xxrrnn/EdgeYOLO-FPGA/docs/端到端执行网络测试方法说明.docx

四、测试方法

1. AI处理器芯片功能（支持ResNet、YOLO等主流深度神经网络）

（1）测试范围和端到端执行边界

使用项目顶层目录中的run.py作为AI处理器FPGA实物测试的统一入口。测试从原始JPEG图片开始，依次完成主机端图片预处理、模型程序和数据下发、FPGA主体网络执行、结果读回、Golden数值比对以及主机端网络头处理，最终生成YOLOv5n检测结果或ResNet18分类结果。

本测试所称“端到端”是由Windows主机与FPGA共同完成的异构执行流程。YOLOv5n在FPGA中执行model.0至model.23的backbone和FPN/PAN neck，model.24 Detect head、decode和NMS在主机CPU执行；ResNet18在FPGA中执行全部20个卷积、stem maxpool、downsample和residual add，Global Average Pool、FC和Top-k在主机CPU执行。Golden计算只用于验证FPGA输出，不属于被测网络的FPGA运算。

表1. 网络端到端执行边界

网络 | FPGA内执行 | Windows主机执行
YOLOv5n | model.0-model.23；57个卷积；im2col、DCIM矩阵乘、QA、DQA、maxpool、upsample和拼接 | 图片读取与letterbox；model.24 Detect head；decode、NMS、坐标映射、JSON和画框
ResNet18 | conv1、stem maxpool、4个stage、8个BasicBlock、20个卷积、downsample和residual add | 图片预处理；Global Average Pool、FC、logits排序、Top-k、JSON和结果图片
数值验证 | 不执行 | compare_one_shot.py生成Golden特征并与FPGA输出比较

（2）FPGA烧录和XDMA运行环境准备

FPGA板卡采用AMD/Xilinx VCU128，器件型号为xcvu37p-fsvh2892-2L-e。正式测试使用项目顶层目录bitstream文件夹下的edgeyolo_c1773f6_w8a8_w16a16w.bit。该bitstream对应250MHz主时钟和8个DCIM Tile，支持native INT8和widened INT16数据通路。

正式测试前，在连接VCU128 JTAG接口的计算机上打开Vivado Hardware Manager，连接目标器件并执行Program Device。run.py不会自动烧录bitstream。烧录计算机和Windows XDMA运行主机可以不是同一台，但板卡在烧录后必须保持供电，PCIe接口必须连接到运行run.py的Windows主机。烧录后重启Windows主机或重新枚举PCIe设备，在设备管理器中确认XDMA设备正常启动，再使用tests/bin/xdma_info.exe检查XDMA通道，并确认h2c_0和c2h_0能够访问。

Vivado/JTAG只负责配置FPGA逻辑；后续模型权重、输入数据、程序指令和控制寄存器均由Windows主机通过PCIe XDMA配置。因此报告中应分别记录“bitstream烧录”和“XDMA运行数据下发”，不能把二者合并描述为同一个步骤。

（3）输入图片和测试用例

正式测试输入取自项目顶层目录examples/coco和examples/imagenet。examples/coco/manifest.json记录20张COCO val2017图片，用于YOLOv5n目标检测；examples/imagenet/manifest.json记录20张ImageNet图片及其synset、类别编号和类别名称，用于ResNet18分类。每张图片分别执行INT8和widened INT16两种数据通路，因此YOLOv5n形成40个用例，ResNet18形成40个用例，共执行80个FPGA实测用例。

单次默认运行时，YOLOv5n输入为examples/coco/000000000139.jpg，ResNet18输入为examples/imagenet/n01443537_goldfish.JPEG。完整端到端测试在Windows XDMA主机的项目顶层目录执行以下命令：

python run.py --acceptance --network all --yolo-precision both --resnet-precision both --acceptance-examples 20 --vcs skip --verilator skip

该命令只执行FPGA端到端实测，不启动VCS峰值算力测试或本地Verilator预检。若只使用两张默认图片执行YOLOv5n INT8、YOLOv5n widened INT16、ResNet18 INT8和ResNet18 widened INT16四个用例，可直接执行：

python run.py

（4）量化模型的离线解析

模型解析和网络编译属于运行前的离线准备过程，不在每张图片推理时重新执行。正式实测直接使用已经固定的解析目录和artifacts/c1773f6编译产物。

YOLOv5n模型：

model/yolov5n_coco50k_qat/parse_quant_export.py中的parse_export函数读取best.quant.onnx和best.onnx，提取量化权重、权重scale、zero point和激活scale，从浮点模型读取BatchNorm参数，计算DQA scale和bias，将权重从OIHW转换为OHWI，并把各层参数写入weights文件夹下的NPZ文件。该程序还单独保存model.24 Detect head权重，供Windows主机端使用。正式测试使用parsed_int8和parsed_int16_widened两个解析目录。

ResNet18模型：

tests/chip/compiler/frontend/parse_resnet18_vai.py从Vitis AI PTQ模型ResNet_int.onnx中恢复20个卷积层的INT8权重和激活scale，生成DQA scale、bias、residual add输出scale以及FC权重和bias，输出到model/resnet18/parsed_vai。widened INT16目录为model/resnet18/parsed_vai_int16_widened。正式实测不要求重新运行Vitis AI或重新解析原始ONNX。

widened INT16保持INT8量化模型的权重数值和scale不变，只把量化值扩展到INT16数据通路中存储、传输和计算，用于验证FPGA 16bit数据通路；该模式不等同于独立训练和量化的原生W16A16网络。

（5）完整网络编译

神经网络编译入口为tests/chip/compiler/compile.py。正式测试的四组编译命令如下：

python tests/chip/compiler/compile.py --network yolov5n --mode int8 --full --parsed model/yolov5n_coco50k_qat/parsed_int8 --out artifacts/c1773f6/yolo_coco_int8
python tests/chip/compiler/compile.py --network yolov5n --mode int16 --full --parsed model/yolov5n_coco50k_qat/parsed_int16_widened --out artifacts/c1773f6/yolo_coco_int16_widened
python tests/chip/compiler/compile.py --network resnet18 --mode int8 --full --parsed model/resnet18/parsed_vai --out artifacts/c1773f6/resnet18_int8
python tests/chip/compiler/compile.py --network resnet18 --mode int16 --full --parsed model/resnet18/parsed_vai_int16_widened --out artifacts/c1773f6/resnet18_int16_widened

compile.py首先读取解析目录中的network.json和tests/chip/compiler/lowering/hw_caps.yaml，再调用lower_full.py中的lower_full函数，把卷积、maxpool、upsample、concat和residual add转换为处理器操作序列，并完成HBM、Tile IBUF/OBUF、VPU_BUF和WB地址规划。随后，weights_packer.py中的pack_all_layers生成weights.bin，wb_packer.py中的pack_all_layers生成wb.bin，insert_weight_load_ops在执行计划中插入逐层HBM到IBUF的权重搬运操作，encode_isa.py中的encode_plan将执行计划编码为32bit指令。

表2. 网络编译产物及作用

文件 | 作用
plan.json | 网络模式、地址表、输入输出位置、输出形状、数据类型和完整操作序列
program.bin / program.hex | 下发到FPGA指令存储器的二进制/十六进制程序
program_manifest.json | 程序分段信息；当前ResNet18 widened INT16使用两个程序段
weights.bin | 完整网络量化权重；每个one-shot用例开始时一次性上传到HBM
wb.bin | QA/DQA scale、bias等VPU参数
weights_layout.json | 各层权重在weights.bin中的偏移和大小
wb_layout.json | 各层scale、bias和VPU_BUF scratch偏移
memory_map.md | 编译器生成的可读存储地址说明

正式验收默认使用artifacts/c1773f6中已经固定的四组产物。run.py中的run_one_shot_fpga只有在指定编译目录缺少plan.json或显式要求重新编译时才调用_compile_one_shot_artifact。正式测试目录已经包含plan.json，因此测试过程中不重新生成模型参数。

（6）run.py的软件调用过程

run.py中的main函数解析网络、精度、输入图片和输出目录。使用--acceptance时，main调用run_acceptance_suite，按照数据集清单和精度组合建立80个用例。每个用例调用run_one_shot_fpga，并按以下顺序启动三个子程序：

1. tests/chip/runtime/hw_runner_win.py：完成图片预处理、XDMA下发、FPGA启动、状态轮询和结果读回。
2. tests/chip/runtime/compare_one_shot.py：生成软件Golden特征并与FPGA二进制输出逐元素比较。
3. tests/chip/runtime/one_shot_host_head.py：执行YOLO Detect head或ResNet GAP、FC和Top-k，生成最终JSON。

三个子程序均通过run.py中的_run_checked调用，并使用subprocess.run(check=True)执行。任何子程序以非零状态退出时，单次运行立即失败；在acceptance模式下，run_acceptance_suite捕获该异常，把对应图片和精度记录为FAIL，并继续执行后续用例。

（7）输入图片预处理和量化

YOLOv5n：

hw_runner_win.py中的make_yolo_input调用tests/chip/unit-tb/run.py中的load_image、letterbox和preprocess_yolov5n。load_image把JPEG读取为RGB uint8数组；letterbox保持长宽比缩放，并使用像素值114填充到320×320；preprocess_yolov5n把像素除以255，再按照解析目录network.json中的input_act_scale执行round和clip，生成INT8输入。widened INT16模式使用同一量化网格，并把量化结果保存为INT16。程序同时保留缩放比例和padding，用于最后把检测框坐标映射回原图。

ResNet18：

make_resnet_input调用tests/chip/unit-tb/resnet_e2e.py中的configure_resnet_precision、load_image和preprocess_resnet18。图片先缩放到256×256，再中心裁剪为224×224；像素除以255后使用ImageNet mean=[0.485,0.456,0.406]和std=[0.229,0.224,0.225]归一化，最后按照第一层输入激活scale量化为INT8或INT16。

硬件输入对齐：

im2col_unit按照每个像素16字节的步长读取第一层输入。hw_runner_win.py中的_pad_nhwc_input把三通道NHWC输入补零到每像素16字节。YOLOv5n实际上传320×320×16=1,638,400字节，ResNet18实际上传224×224×16=802,816字节。补零只改变内存布局，不改变三个有效通道的量化值。

（8）XDMA配置、数据和指令下发

Windows XDMA封装位于tests/chip/unit-tb/xdma_win.py。XDMAWin.write把待写数据保存为临时二进制文件，再调用tests/bin/xdma_rw.exe的h2c_0 write命令；XDMAWin.read调用c2h_0 read命令并读取临时输出文件。write_u32和read_u32在上述读写函数基础上完成32bit控制寄存器访问。

xdma_rw.exe h2c_0 write <address> -b -f <file> -l <length>
xdma_rw.exe c2h_0 read <address> -b -f <file> -l <length>

表3. FPGA运行时地址空间

区域 | 基地址 | 作用
HBM | 0x000000000 | 保存完整网络权重
Tile IBUF | 0x100000000 | 8个Tile的局部输入和权重缓冲区
Tile OBUF | 0x101000000 | 8个Tile的局部计算输出
VPU_BUF | 0x102000000 | 输入、中间特征、最终输出和WB scratch
WB | 0x103000000 | 当前层QA/DQA scale和bias
INST | 0x104000000 | 指令存储器
REGS | 0x105000000 | 解码器控制和状态寄存器

hw_runner_win.py中的main函数首先读取编译目录中的plan.json，从address_map和host_io取得存储基地址、输入偏移、输出偏移、输出形状和数据类型，然后按以下顺序执行：

1. 默认调用soft_reset_decoder，将INST_COUNT写0，并向DECODER_CTRL写1和0，对指令译码器执行局部软复位。

2. 读取DECODER_STATUS；若bit0为1，表示解码器仍处于busy状态，本次运行停止。

3. 把weights.bin一次性写入HBM基地址加0x200000偏移。

4. 把wb.bin写入wb_layout.json指定的VPU_BUF scratch区域。

5. 把预处理并补齐后的输入写入host_io.input_obuf_off；当前四组正式程序均从VPU_BUF偏移0存放输入。

6. 调用load_programs读取program.bin；若存在program_manifest.json，则按manifest顺序读取多个程序段。

7. 把当前程序段写入0x104000000的INST存储器。

write_chunked默认按1MB分块写入大文件。每次重要写入完成后，verify_write_tail读回写入区域末尾最多16字节，使PCIe/XDMA写缓冲完成提交。主机不逐层上传权重；完整weights.bin只上传一次，FPGA运行期间由程序中的CDMA操作把当前层权重从HBM搬运到对应Tile IBUF。

（9）FPGA程序启动和主体网络执行

程序和数据准备完成后，hw_runner_win.py中的start_and_poll将当前程序段的32bit指令字数写入REGS+0x3C的INST_COUNT寄存器，再向REGS+0x38的DECODER_CTRL依次写1和0，产生程序启动脉冲。程序运行期间每2ms读取REGS+0x40的DECODER_STATUS：bit1为1表示本程序段完成，bit31为1表示解码器报告错误；超过--one-shot-poll-timeout-s仍未完成则判定timeout。

指令译码器按照plan.json中的操作顺序调度CDMA、VPU和DCIM。cdma_copy/cdma_stride完成HBM、Tile IBUF/OBUF、VPU_BUF和WB之间的数据搬运；VPU im2col把卷积输入特征转换为矩阵乘输入；dcim_layer控制8个DCIM Tile完成INT8或widened INT16矩阵计算；DQA对整数累加结果乘scale、加bias并执行激活；QA把FP32特征重新量化为下一卷积层所需的整数数据；mp、us和ad分别执行maxpool、upsample和residual add；concat通过编译器规划的通道偏移和CDMA搬运完成。

网络中间特征始终保存在FPGA缓冲区中，程序执行期间不返回主机。ResNet18 widened INT16程序虽然分为两个指令段，但第一段结束后中间特征仍保留在VPU_BUF中，Windows主机只替换INST中的下一段指令，不执行中间网络计算。

（10）FPGA输出读回

全部程序段执行完成后，hw_runner_win.py中的output_specs读取plan.json中的host_io。read_chunked通过XDMA C2H通道按--one-shot-read-chunk-bytes指定的大小分块读回输出。

表4. FPGA输出特征

网络与精度 | FPGA输出 | 数据类型
YOLOv5n INT8 / widened INT16 | PAN_P3 40×40×64；PAN_P4 20×20×128；PAN_P5 10×10×256 | FP32
ResNet18 INT8 | GAP之前的7×7×512特征 | INT8
ResNet18 widened INT16 | GAP之前的7×7×512特征 | INT16

YOLOv5n三组特征分别保存为features/PAN_P3.bin、features/PAN_P4.bin和features/PAN_P5.bin。ResNet18把7×7×512特征保存为当前用例的主输出bin文件。每次运行同时生成同名的_timing.json，记录权重、WB、输入和程序上传时间，各程序段执行和状态轮询时间，输出读回时间及整个用例的主机侧总时间。该时间是Windows主机测得的墙钟时间，不等同于VCS峰值算力测试中的纯硬件有效计算窗口。

（11）FPGA输出和Golden结果比对

FPGA结果读回后，run.py调用tests/chip/runtime/compare_one_shot.py。YOLOv5n使用run_yolo_compiler_golden读取network.json和各层NPZ参数，按照YOLOV5N_SCHEDULE依次执行conv、save、load、concat、upsample、maxpool和add，卷积部分采用与FPGA相同的im2col、整数矩阵乘、DQA scale、bias和量化规则，生成PAN_P3、PAN_P4和PAN_P5参考特征。

ResNet18使用run_resnet_compiler_golden依次执行conv1、3×3 stride-2 maxpool、8个BasicBlock、downsample和residual add，生成与FPGA输出位置一致的7×7×512参考特征。

compare_one_shot.py按照plan.json中的输出形状和数据类型读取FPGA二进制结果，把FPGA输出和Golden输出转换为FP32后逐元素相减，并计算最大绝对误差max_abs、平均绝对误差mean_abs和均方根误差rmse。默认atol为1e-3；任一应比对输出的max_abs大于1e-3时，程序以非零状态退出，该用例判定为FAIL。Golden计算、误差统计和PASS/FAIL判断均在Windows CPU上执行，不属于FPGA网络运算。正式测试需要保存终端日志，用于记录每组输出的误差统计。

（12）主机端网络头和最终结果

YOLOv5n：

one_shot_host_head.py中的_run_yolo读取PAN_P3、PAN_P4和PAN_P5，根据三个尺度的激活scale把FPGA输出的FP32特征重新量化到INT8或INT16网格，再调用tests/chip/unit-tb/detect_head.py中的DetectHead.forward执行model.24的三个1×1卷积。DetectHead.postprocess完成sigmoid、anchor/grid decode、置信度过滤和分类别NMS。程序最后依据letterbox比例和padding把检测框映射回原图，生成包含bbox、conf、class_score、class_id和class_name的JSON。run.py中的_draw_yolo_detections把检测框、类别和置信度绘制到原始图片。

ResNet18：

one_shot_host_head.py中的_run_resnet读取7×7×512 INT8或INT16特征，对两个空间维度求均值完成Global Average Pool，再乘以最后一个BasicBlock的输出激活scale。程序从对应解析目录weights/fc.npz读取FC weight和bias，计算logits=gap×weight+bias，对logits从大到小排序得到Top-5类别，并从model/resnet18/imagenet_labels.json读取类别名称。run.py中的_draw_resnet_classification生成带Top-5文字面板的结果图片。当前代码未执行softmax，因此JSON中的score为原始logit，不应写成分类概率。

（13）输出文件位置和内容

使用两张默认图片执行python run.py时，输出位于output/inference。使用完整acceptance命令时，输出位于output/acceptance。主要目录如下：

output/inference/yolo_coco/one_shot_int8
output/inference/yolo_coco/one_shot_int16
output/inference/resnet/one_shot_int8
output/inference/resnet/one_shot_int16
output/acceptance/yolo_coco/one_shot_int8
output/acceptance/yolo_coco/one_shot_int16
output/acceptance/resnet/one_shot_int8
output/acceptance/resnet/one_shot_int16

表5. 单个用例主要输出文件

文件 | 内容
*_fpga_oneshot.bin | FPGA主输出二进制特征
features/PAN_P3.bin等 | YOLOv5n三尺度FP32 PAN特征
*_fpga_oneshot.json | 最终检测结果或ResNet18 Top-k结果
*_fpga_oneshot.jpg | 带检测框或Top-k文字面板的结果图片
*_fpga_oneshot_timing.json | 权重、WB、输入、程序、执行和读回阶段时间

全部用例结束后，run_acceptance_suite在output/acceptance中生成acceptance_report.json和acceptance_report.md，记录每张图片的网络、精度、PASS/FAIL、检测数量或Top-1类别及运行时间。

（14）测试判定口径

当前run_acceptance_suite把“FPGA特征通过Golden比对，且主机端网络头能够正常完成”作为单个用例的PASS条件。ResNet18的top1_matches_sample_label会写入汇总报告，但当前不作为用例FAIL门槛；YOLOv5n记录检测数量，但不计算COCO mAP。因此，本测试可以证明FPGA主体网络计算正确、YOLOv5n和ResNet18端到端流程可运行，以及INT8和widened INT16数据通路能够完成实测；不能把该结果直接表述为完整ImageNet分类精度或COCO mAP测试。

正式报告应至少保留：Vivado烧录截图、Windows设备管理器XDMA状态、完整测试命令和终端日志、四组网络与精度的PASS/FAIL汇总、代表性YOLO检测图片、代表性ResNet18 Top-5图片、FPGA与Golden误差统计，以及各用例的timing.json。

（15）软件文件和函数调用汇总

表6. 端到端软件调用链

阶段 | 文件与函数 | 作用
测试入口 | run.py::main | 解析网络、精度、输入和运行模式
用例组织 | run.py::run_acceptance_suite | 按manifest、网络和精度建立80个测试用例
单次执行 | run.py::run_one_shot_fpga | 选择编译产物并依次启动硬件、比对和主机网络头
YOLO输入 | hw_runner_win.py::make_yolo_input | letterbox、归一化和INT8/INT16量化
ResNet输入 | hw_runner_win.py::make_resnet_input | resize、center crop、ImageNet归一化和量化
输入对齐 | hw_runner_win.py::_pad_nhwc_input | 把三通道输入补零到每像素16字节
XDMA写入 | xdma_win.py::XDMAWin.write/write_u32 | 通过h2c_0写数据、指令和控制寄存器
XDMA读回 | xdma_win.py::XDMAWin.read/read_u32 | 通过c2h_0读取状态和FPGA输出
程序加载 | hw_runner_win.py::load_programs | 读取单段program.bin或program_manifest中的多段程序
启动轮询 | hw_runner_win.py::start_and_poll | 配置INST_COUNT、产生启动脉冲并轮询DECODER_STATUS
结果读回 | hw_runner_win.py::output_specs/read_chunked | 按plan.json读取指定输出特征
YOLO Golden | compare_one_shot.py::run_yolo_compiler_golden | 生成三尺度PAN参考特征
ResNet Golden | compare_one_shot.py::run_resnet_compiler_golden | 生成7×7×512参考特征
数值判定 | compare_one_shot.py::main | 计算max_abs、mean_abs、rmse并按atol判定
YOLO主机头 | one_shot_host_head.py::_run_yolo | Detect head、decode、NMS和检测JSON
ResNet主机头 | one_shot_host_head.py::_run_resnet | GAP、FC、logits排序和Top-k JSON
结果图片 | run.py::_draw_yolo_detections/_draw_resnet_classification | 绘制检测框或分类Top-k面板
