xxrrnn/EdgeYOLO-FPGA/rtl/vpu/CDMA_Controller.sv

`timescale 1ns / 1ns

`include "chip_defines.vh"
`ifndef CDMA_COOLDOWN_CYCLES
`define CDMA_COOLDOWN_CYCLES 2000
`endif

	module CDMA_Controller # (
        parameter int CDMA_BASE_ADDR = 0,
        parameter int C_CDMA_AXILM_ADDR_WIDTH = 32,
        parameter int C_CDMA_AXILM_DATA_WIDTH = 32
    ) (
        input wire        clk,
        input wire        rst_n,
        input wire        cdma_start,
        input wire        cdma_config_valid,
        output wire       cdma_config_ready,
        input wire [31:0] cdma_src_addr_msb,
        input wire [31:0] cdma_src_addr_lsb,
        input wire [31:0] cdma_dst_addr_msb, 
        input wire [31:0] cdma_dst_addr_lsb,
        input wire [31:0] cdma_length,

        output logic [C_CDMA_AXILM_ADDR_WIDTH-1 : 0] cdma_axilm_awaddr,
        output logic [2 : 0] cdma_axilm_awprot,
        output logic cdma_axilm_awvalid,
        input  logic cdma_axilm_awready,
        output logic [C_CDMA_AXILM_DATA_WIDTH-1 : 0] cdma_axilm_wdata,
        output logic [C_CDMA_AXILM_DATA_WIDTH/8-1 : 0] cdma_axilm_wstrb,
        output logic cdma_axilm_wvalid,
        input  logic cdma_axilm_wready,
        input  logic [1 : 0] cdma_axilm_bresp,
        input  logic cdma_axilm_bvalid,
        output logic cdma_axilm_bready,
        output logic [C_CDMA_AXILM_ADDR_WIDTH-1 : 0] cdma_axilm_araddr,
        output logic [2 : 0] cdma_axilm_arprot,
        output logic cdma_axilm_arvalid,
        input  logic cdma_axilm_arready,
        input  logic [C_CDMA_AXILM_DATA_WIDTH-1 : 0] cdma_axilm_rdata,
        input  logic [1 : 0] cdma_axilm_rresp,
        input  logic cdma_axilm_rvalid,
        output logic cdma_axilm_rready
    );

    wire aw_handshake_cdma = cdma_axilm_awready && cdma_axilm_awvalid;
    wire w_handshake_cdma  = cdma_axilm_wready  && cdma_axilm_wvalid;
    wire b_handshake_cdma  = cdma_axilm_bvalid  && cdma_axilm_bready;
    wire ar_handshake_cdma = cdma_axilm_arready && cdma_axilm_arvalid;
    wire r_handshake_cdma  = cdma_axilm_rvalid  && cdma_axilm_rready;

    reg [31:0] cdma_src_addr_msb_reg;
    reg [31:0] cdma_src_addr_lsb_reg;
    reg [31:0] cdma_dst_addr_msb_reg;
    reg [31:0] cdma_dst_addr_lsb_reg;
    reg [31:0] cdma_length_reg;
    reg        sr_idle_flag;  // 锁存 SR 读取结果的 IDLE 位
    reg [$clog2(`CDMA_COOLDOWN_CYCLES+1)-1:0] cooldown_cnt;
    reg        write_addr_done;
    reg        write_data_done;
    reg        write_resp_done;

    assign cdma_axilm_awprot = '0;
    assign cdma_axilm_arprot = '0;

    typedef enum logic [7:0] {
        IDLE                = 8'd0,
        CDMA_CONFIG         = 8'd1,   // 发起 SR 读请求
        CDMA_CHECK          = 8'd2,   // 等待 SR 响应，确认 CDMA IDLE
        CDMA_ENABLE_IRQ     = 8'd3,
        CDMA_ENABLE_IRQ_CLR = 8'd4,
        CDMA_WRITE_SRC_MSB  = 8'd5,
        CDMA_WRITE_SRC_MSB_CLR = 8'd6,
        CDMA_WRITE_SRC_LSB  = 8'd7,
        CDMA_WRITE_SRC_LSB_CLR = 8'd8,
        CDMA_WRITE_DST_MSB  = 8'd9,
        CDMA_WRITE_DST_MSB_CLR = 8'd10,
        CDMA_WRITE_DST_LSB  = 8'd11,
        CDMA_WRITE_DST_LSB_CLR = 8'd12,
        CDMA_WRITE_LEN      = 8'd13,
        CDMA_WRITE_LEN_CLR  = 8'd14,
        CDMA_POLL_ISSUE     = 8'd15,  // 发起 SR 读请求（轮询传输完成）
        CDMA_POLL_WAIT      = 8'd16,  // 等待 SR 响应
        CDMA_POLL_CHECK     = 8'd17,  // 检查 IDLE 位，决定结束或重试
        CDMA_COOLDOWN       = 8'd18   // 等待 AXI 写路径完全 flush
    } state_t;
    (* fsm_encoding = "one_hot" *) state_t n_state, c_state;

    assign cdma_config_ready = c_state == IDLE;

    wire cdma_write_state =
        (c_state == CDMA_ENABLE_IRQ) ||
        (c_state == CDMA_WRITE_SRC_MSB) ||
        (c_state == CDMA_WRITE_SRC_LSB) ||
        (c_state == CDMA_WRITE_DST_MSB) ||
        (c_state == CDMA_WRITE_DST_LSB) ||
        (c_state == CDMA_WRITE_LEN);
    wire cdma_write_done =
        (write_addr_done || aw_handshake_cdma) &&
        (write_data_done || w_handshake_cdma) &&
        (write_resp_done || b_handshake_cdma);

    always_ff @(posedge clk or negedge rst_n) begin
        if (!rst_n)
            c_state <= IDLE;
        else
            c_state <= n_state;
    end

    always_comb begin
        n_state = c_state;
        case (c_state)
            IDLE:             if (cdma_start) n_state = CDMA_CONFIG;
            CDMA_CONFIG:      n_state = CDMA_CHECK;
            CDMA_CHECK:       if (r_handshake_cdma && cdma_axilm_rdata[1]) n_state = CDMA_ENABLE_IRQ;

            CDMA_ENABLE_IRQ:        if (cdma_write_done) n_state = CDMA_ENABLE_IRQ_CLR;
            CDMA_ENABLE_IRQ_CLR:    n_state = CDMA_WRITE_SRC_MSB;
            CDMA_WRITE_SRC_MSB:     if (cdma_write_done) n_state = CDMA_WRITE_SRC_MSB_CLR;
            CDMA_WRITE_SRC_MSB_CLR: n_state = CDMA_WRITE_SRC_LSB;
            CDMA_WRITE_SRC_LSB:     if (cdma_write_done) n_state = CDMA_WRITE_SRC_LSB_CLR;
            CDMA_WRITE_SRC_LSB_CLR: n_state = CDMA_WRITE_DST_MSB;
            CDMA_WRITE_DST_MSB:     if (cdma_write_done) n_state = CDMA_WRITE_DST_MSB_CLR;
            CDMA_WRITE_DST_MSB_CLR: n_state = CDMA_WRITE_DST_LSB;
            CDMA_WRITE_DST_LSB:     if (cdma_write_done) n_state = CDMA_WRITE_DST_LSB_CLR;
            CDMA_WRITE_DST_LSB_CLR: n_state = CDMA_WRITE_LEN;
            CDMA_WRITE_LEN:         if (cdma_write_done) n_state = CDMA_WRITE_LEN_CLR;
            CDMA_WRITE_LEN_CLR:     n_state = CDMA_POLL_ISSUE;

            // 轮询 CDMA SR 直到 IDLE=1（传输完成）
            CDMA_POLL_ISSUE:  n_state = CDMA_POLL_WAIT;
            CDMA_POLL_WAIT:   if (r_handshake_cdma) n_state = CDMA_POLL_CHECK;
            CDMA_POLL_CHECK:  if (sr_idle_flag) n_state = CDMA_COOLDOWN;
                              else              n_state = CDMA_POLL_ISSUE;

            // 等待 AXI 互连写路径完全 flush 到目标 BRAM
            CDMA_COOLDOWN:    if (cooldown_cnt == `CDMA_COOLDOWN_CYCLES) n_state = IDLE;

            default: n_state = IDLE;
        endcase
    end

    // Register offsets within CDMA peripheral
    localparam logic [31:0] CDMA_CR_OFFSET             = 32'h00000000;
    localparam logic [31:0] CDMA_SR_OFFSET             = 32'h00000004;
    localparam logic [31:0] CDMA_SRC_ADDR_LSB_OFFSET   = 32'h00000018;
    localparam logic [31:0] CDMA_SRC_ADDR_MSB_OFFSET   = 32'h0000001C;
    localparam logic [31:0] CDMA_DST_ADDR_LSB_OFFSET   = 32'h00000020;
    localparam logic [31:0] CDMA_DST_ADDR_MSB_OFFSET   = 32'h00000024;
    localparam logic [31:0] CDMA_LEN_OFFSET            = 32'h00000028;
    localparam int          RUN_STOP_BIT               = 0;
    localparam int          IOC_IRQ_EN_BIT             = 12;
    localparam int          ERR_IRQ_EN_BIT             = 14;

    // 锁存 SR 读取结果
    always_ff @(posedge clk or negedge rst_n) begin
        if (!rst_n)
            sr_idle_flag <= 1'b0;
        else if (r_handshake_cdma)
            sr_idle_flag <= cdma_axilm_rdata[1];
    end

    // Cooldown 计数器：CDMA 完成后等待写路径 flush
    always_ff @(posedge clk or negedge rst_n) begin
        if (!rst_n)
            cooldown_cnt <= '0;
        else if (c_state == CDMA_COOLDOWN)
            cooldown_cnt <= cooldown_cnt + 1;
        else
            cooldown_cnt <= '0;
    end

    always_ff @(posedge clk or negedge rst_n) begin
        if (!rst_n) begin
            write_addr_done <= 1'b0;
            write_data_done <= 1'b0;
            write_resp_done <= 1'b0;
        end else if (!cdma_write_state) begin
            write_addr_done <= 1'b0;
            write_data_done <= 1'b0;
            write_resp_done <= 1'b0;
        end else begin
            if (aw_handshake_cdma) write_addr_done <= 1'b1;
            if (w_handshake_cdma)  write_data_done <= 1'b1;
            if (b_handshake_cdma)  write_resp_done <= 1'b1;
        end
    end

    // AXI-Lite 输出信号
    always_ff @(posedge clk or negedge rst_n) begin
        if (!rst_n) begin
            cdma_axilm_awvalid <= 1'b0;
            cdma_axilm_wvalid  <= 1'b0;
            cdma_axilm_bready  <= 1'b0;
            cdma_axilm_arvalid <= 1'b0;
            cdma_axilm_rready  <= 1'b0;
            cdma_axilm_awaddr  <= '0;
            cdma_axilm_wdata   <= '0;
            cdma_axilm_wstrb   <= '0;
        end else begin
            case (c_state)
                CDMA_CONFIG: begin
                    cdma_axilm_arvalid <= 1;
                    cdma_axilm_araddr  <= CDMA_BASE_ADDR + CDMA_SR_OFFSET;
                    cdma_axilm_rready  <= 1;
                end
                CDMA_CHECK: begin
                    cdma_axilm_arvalid <= ~ar_handshake_cdma;
                    cdma_axilm_araddr  <= CDMA_BASE_ADDR + CDMA_SR_OFFSET;
                    cdma_axilm_rready  <= 1;
                end
                CDMA_ENABLE_IRQ: begin
                    cdma_axilm_awvalid <= ~write_addr_done;
                    cdma_axilm_awaddr  <= CDMA_BASE_ADDR + CDMA_CR_OFFSET;
                    cdma_axilm_wvalid  <= ~write_data_done;
                    // AXI CDMA requires CR.RS=1 before SRC/DST/LEN writes can start a transfer.
                    cdma_axilm_wdata   <= (1 << RUN_STOP_BIT) | (1 << IOC_IRQ_EN_BIT) | (1 << ERR_IRQ_EN_BIT);
                    cdma_axilm_wstrb   <= {C_CDMA_AXILM_DATA_WIDTH/8{1'b1}};
                    cdma_axilm_bready  <= 1;
                end
                CDMA_WRITE_SRC_MSB: begin
                    cdma_axilm_awvalid <= ~write_addr_done;
                    cdma_axilm_awaddr  <= CDMA_BASE_ADDR + CDMA_SRC_ADDR_MSB_OFFSET;
                    cdma_axilm_wvalid  <= ~write_data_done;
                    cdma_axilm_wdata   <= cdma_src_addr_msb_reg;
                    cdma_axilm_wstrb   <= {C_CDMA_AXILM_DATA_WIDTH/8{1'b1}};
                    cdma_axilm_bready  <= 1;
                end
                CDMA_WRITE_SRC_LSB: begin
                    cdma_axilm_awvalid <= ~write_addr_done;
                    cdma_axilm_awaddr  <= CDMA_BASE_ADDR + CDMA_SRC_ADDR_LSB_OFFSET;
                    cdma_axilm_wvalid  <= ~write_data_done;
                    cdma_axilm_wdata   <= cdma_src_addr_lsb_reg;
                    cdma_axilm_wstrb   <= {C_CDMA_AXILM_DATA_WIDTH/8{1'b1}};
                    cdma_axilm_bready  <= 1;
                end
                CDMA_WRITE_DST_MSB: begin
                    cdma_axilm_awvalid <= ~write_addr_done;
                    cdma_axilm_awaddr  <= CDMA_BASE_ADDR + CDMA_DST_ADDR_MSB_OFFSET;
                    cdma_axilm_wvalid  <= ~write_data_done;
                    cdma_axilm_wdata   <= cdma_dst_addr_msb_reg;
                    cdma_axilm_wstrb   <= {C_CDMA_AXILM_DATA_WIDTH/8{1'b1}};
                    cdma_axilm_bready  <= 1;
                end
                CDMA_WRITE_DST_LSB: begin
                    cdma_axilm_awvalid <= ~write_addr_done;
                    cdma_axilm_awaddr  <= CDMA_BASE_ADDR + CDMA_DST_ADDR_LSB_OFFSET;
                    cdma_axilm_wvalid  <= ~write_data_done;
                    cdma_axilm_wdata   <= cdma_dst_addr_lsb_reg;
                    cdma_axilm_wstrb   <= {C_CDMA_AXILM_DATA_WIDTH/8{1'b1}};
                    cdma_axilm_bready  <= 1;
                end
                CDMA_WRITE_LEN: begin
                    cdma_axilm_awvalid <= ~write_addr_done;
                    cdma_axilm_awaddr  <= CDMA_BASE_ADDR + CDMA_LEN_OFFSET;
                    cdma_axilm_wvalid  <= ~write_data_done;
                    cdma_axilm_wdata   <= cdma_length_reg;
                    cdma_axilm_wstrb   <= {C_CDMA_AXILM_DATA_WIDTH/8{1'b1}};
                    cdma_axilm_bready  <= 1;
                end
                CDMA_POLL_ISSUE: begin
                    // 发起读 SR 请求
                    cdma_axilm_arvalid <= 1;
                    cdma_axilm_araddr  <= CDMA_BASE_ADDR + CDMA_SR_OFFSET;
                    cdma_axilm_rready  <= 1;
                end
                CDMA_POLL_WAIT: begin
                    // 等待读响应，ar握手后清 arvalid
                    cdma_axilm_arvalid <= ~ar_handshake_cdma;
                    cdma_axilm_araddr  <= CDMA_BASE_ADDR + CDMA_SR_OFFSET;
                    cdma_axilm_rready  <= 1;
                end
                CDMA_POLL_CHECK: begin
                    // 清零所有信号，检查结果
                    cdma_axilm_awvalid <= 1'b0;
                    cdma_axilm_wvalid  <= 1'b0;
                    cdma_axilm_bready  <= 1'b0;
                    cdma_axilm_arvalid <= 1'b0;
                    cdma_axilm_rready  <= 1'b0;
                end
                // _CLR 状态：清零所有 valid 信号
                CDMA_ENABLE_IRQ_CLR,
                CDMA_WRITE_SRC_MSB_CLR,
                CDMA_WRITE_SRC_LSB_CLR,
                CDMA_WRITE_DST_MSB_CLR,
                CDMA_WRITE_DST_LSB_CLR,
                CDMA_WRITE_LEN_CLR: begin
                    cdma_axilm_awvalid <= 1'b0;
                    cdma_axilm_wvalid  <= 1'b0;
                    cdma_axilm_bready  <= 1'b0;
                    cdma_axilm_arvalid <= 1'b0;
                    cdma_axilm_rready  <= 1'b0;
                end
                IDLE: begin
                    cdma_axilm_awvalid <= 1'b0;
                    cdma_axilm_wvalid  <= 1'b0;
                    cdma_axilm_bready  <= 1'b0;
                    cdma_axilm_arvalid <= 1'b0;
                    cdma_axilm_rready  <= 1'b0;
                end
                default: begin
                    cdma_axilm_awvalid <= 1'b0;
                    cdma_axilm_wvalid  <= 1'b0;
                    cdma_axilm_bready  <= 1'b0;
                    cdma_axilm_arvalid <= 1'b0;
                    cdma_axilm_rready  <= 1'b0;
                end
            endcase
        end
    end

    // 锁存配置参数
    always_ff @(posedge clk or negedge rst_n) begin
        if(!rst_n) begin
            cdma_src_addr_msb_reg       <= '0;
            cdma_src_addr_lsb_reg       <= '0;
            cdma_dst_addr_msb_reg       <= '0;
            cdma_dst_addr_lsb_reg       <= '0;
            cdma_length_reg             <= '0;
        end else begin
            if(cdma_config_valid && cdma_config_ready) begin
                cdma_src_addr_msb_reg       <= cdma_src_addr_msb;
                cdma_src_addr_lsb_reg       <= cdma_src_addr_lsb;
                cdma_dst_addr_msb_reg       <= cdma_dst_addr_msb;
                cdma_dst_addr_lsb_reg       <= cdma_dst_addr_lsb;
                cdma_length_reg             <= cdma_length;
            end
        end
    end

endmodule
