xxrrnn/EdgeYOLO-FPGA/xdc/chip/chip.xdc

# DCIM_Array Chip XDC constraints
# Based on VCU128 board (xcvu37p-fsvh2892-2L-e)

# PCIe reference clock
set_property PACKAGE_PIN AR14 [get_ports pcie_refclk_clk_n]
set_property PACKAGE_PIN AR15 [get_ports pcie_refclk_clk_p]

# CPU reset button
set_property PACKAGE_PIN BM29 [get_ports cpu_reset]
set_property IOSTANDARD LVCMOS12 [get_ports cpu_reset]

# User link up LED
set_property PACKAGE_PIN BH24 [get_ports user_lnk_up_0]
set_property IOSTANDARD LVCMOS18 [get_ports user_lnk_up_0]

# Bitstream configuration
set_property CONFIG_MODE SPIx4 [current_design]
set_property BITSTREAM.CONFIG.CONFIGRATE 63.8 [current_design]
