xxrrnn/EdgeYOLO-FPGA/rtl/ref/DCIM/src/sram/rf128x128/verilog/rf128x128.v

/* verilog_memcomp Version: c0.4.19-EAC */
/* common_memcomp Version: c0.4.19-EAC */
/* lang compiler Version: 4.14.4-EAC Mar 31 2020 06:59:59 */
//
//       CONFIDENTIAL AND PROPRIETARY SOFTWARE OF ARM PHYSICAL IP, INC.
//      
//       Copyright (c) 1993 - 2026 ARM Physical IP, Inc.  All Rights Reserved.
//      
//       Use of this Software is subject to the terms and conditions of the
//       applicable license agreement with ARM Physical IP, Inc.
//       In addition, this Software is protected by patents, copyright law 
//       and international treaties.
//      
//       The copyright notice(s) in this Software does not indicate actual or
//       intended publication of this Software.
//
//      Verilog model for High Density Single Port Register File SVT MVT Compiler
//
//       Instance Name:              rf128x128
//       Words:                      128
//       Bits:                       128
//       Mux:                        2
//       Drive:                      6
//       Write Mask:                 On
//       Write Thru:                 Off
//       Extra Margin Adjustment:    On
//       Test Muxes                  Off
//       Power Gating:               Off
//       Retention:                  On
//       Pipeline:                   Off
//       Read Disturb Test:	        Off
//       
//       Creation Date:  Fri Apr  3 17:16:28 2026
//       Version: 	r0p0
//
//      Modeling Assumptions: This model supports full gate level simulation
//          including proper x-handling and timing check behavior.  Unit
//          delay timing is included in the model. Back-annotation of SDF
//          (v3.0 or v2.1) is supported.  SDF can be created utilyzing the delay
//          calculation views provided with this generator and supported
//          delay calculators.  All buses are modeled [MSB:LSB].  All 
//          ports are padded with Verilog primitives.
//
//      Modeling Limitations: None.
//
//      Known Bugs: None.
//
//      Known Work Arounds: N/A
//
`timescale 1 ns/1 ps
`define ARM_MEM_PROP 1.000
`define ARM_MEM_RETAIN 1.000
`define ARM_MEM_PERIOD 3.000
`define ARM_MEM_WIDTH 1.000
`define ARM_MEM_SETUP 1.000
`define ARM_MEM_HOLD 0.500
`define ARM_MEM_COLLISION 3.000
// If ARM_UD_MODEL is defined at Simulator Command Line, it Selects the Fast Functional Model
`ifdef ARM_UD_MODEL

// Following parameter Values can be overridden at Simulator Command Line.

// ARM_UD_DP Defines the delay through Data Paths, for Memory Models it represents BIST MUX output delays.
`ifdef ARM_UD_DP
`else
`define ARM_UD_DP #0.001
`endif
// ARM_UD_CP Defines the delay through Clock Path Cells, for Memory Models it is not used.
`ifdef ARM_UD_CP
`else
`define ARM_UD_CP
`endif
// ARM_UD_SEQ Defines the delay through the Memory, for Memory Models it is used for CLK->Q delays.
`ifdef ARM_UD_SEQ
`else
`define ARM_UD_SEQ #0.01
`endif

`celldefine
// If POWER_PINS is defined at Simulator Command Line, it selects the module definition with Power Ports
`ifdef POWER_PINS
module rf128x128 (VDDCE, VDDPE, VSSE, q, clk, cen, wen, a, d, ema, emaw, emas, gwen,
    ret1n);
`else
module rf128x128 (q, clk, cen, wen, a, d, ema, emaw, emas, gwen, ret1n);
`endif

  parameter ASSERT_PREFIX = "";
  parameter BITS = 128;
  parameter WORDS = 128;
  parameter MUX = 2;
  parameter MEM_WIDTH = 256; // redun block size 2, 128 on left, 128 on right
  parameter MEM_HEIGHT = 64;
  parameter WP_SIZE = 1 ;
  parameter UPM_WIDTH = 3;
  parameter UPMW_WIDTH = 2;
  parameter UPMS_WIDTH = 1;

`ifdef ARM_DISABLE_EMA_CHECK
parameter ARM_LOCAL_DISABLE_EMA_CHECK = 1;
`else
parameter ARM_LOCAL_DISABLE_EMA_CHECK = 0;
`endif

  parameter ARM_REF_EMA_VALUE = 2**UPM_WIDTH-1;
  parameter ARM_REF_EMAW_VALUE = 2**UPMW_WIDTH-1;
  parameter ARM_REF_EMAS_VALUE = 2**UPMS_WIDTH-1;

  output [127:0] q;
  input  clk;
  input  cen;
  input [127:0] wen;
  input [6:0] a;
  input [127:0] d;
  input [2:0] ema;
  input [1:0] emaw;
  input  emas;
  input  gwen;
  input  ret1n;
`ifdef POWER_PINS
  inout VDDCE;
  inout VDDPE;
  inout VSSE;
`endif
`ifdef POWER_PINS
  reg bad_VDDCE;
  reg bad_VDDPE;
  reg bad_VSSE;
  reg bad_power;
`endif
 wire corrupt_power;
`ifdef POWER_PINS
  assign corrupt_power = bad_power;
`else
  assign corrupt_power = 1'b0;
`endif

  reg pre_charge_st;
  integer row_address;
  integer mux_address;
  initial row_address = 0;
  initial mux_address = 0;
  reg [255:0] mem [0:63];
  reg [255:0] row, row_t;
  reg LAST_clk;
  reg [255:0] row_mask;
  reg [255:0] new_data;
  reg [255:0] data_out;
  reg [127:0] readLatch0;
  reg [127:0] shifted_readLatch0;
  reg [127:0] q_int;
  reg [127:0] writeEnable;
  reg clk0_int;

  wire [127:0] q_;
 wire  clk_;
  wire  cen_;
  reg  cen_int;
  reg  cen_p2;
  wire [127:0] wen_;
  reg [127:0] wen_int;
  wire [6:0] a_;
  reg [6:0] a_int;
  wire [127:0] d_;
  reg [127:0] d_int;
  wire [2:0] ema_;
  reg [2:0] ema_int;
  wire [1:0] emaw_;
  reg [1:0] emaw_int;
  wire  emas_;
  reg  emas_int;
  wire  gwen_;
  reg  gwen_int;
  wire  ret1n_;
  reg  ret1n_int;

  assign q[0] = q_[0]; 
  assign q[1] = q_[1]; 
  assign q[2] = q_[2]; 
  assign q[3] = q_[3]; 
  assign q[4] = q_[4]; 
  assign q[5] = q_[5]; 
  assign q[6] = q_[6]; 
  assign q[7] = q_[7]; 
  assign q[8] = q_[8]; 
  assign q[9] = q_[9]; 
  assign q[10] = q_[10]; 
  assign q[11] = q_[11]; 
  assign q[12] = q_[12]; 
  assign q[13] = q_[13]; 
  assign q[14] = q_[14]; 
  assign q[15] = q_[15]; 
  assign q[16] = q_[16]; 
  assign q[17] = q_[17]; 
  assign q[18] = q_[18]; 
  assign q[19] = q_[19]; 
  assign q[20] = q_[20]; 
  assign q[21] = q_[21]; 
  assign q[22] = q_[22]; 
  assign q[23] = q_[23]; 
  assign q[24] = q_[24]; 
  assign q[25] = q_[25]; 
  assign q[26] = q_[26]; 
  assign q[27] = q_[27]; 
  assign q[28] = q_[28]; 
  assign q[29] = q_[29]; 
  assign q[30] = q_[30]; 
  assign q[31] = q_[31]; 
  assign q[32] = q_[32]; 
  assign q[33] = q_[33]; 
  assign q[34] = q_[34]; 
  assign q[35] = q_[35]; 
  assign q[36] = q_[36]; 
  assign q[37] = q_[37]; 
  assign q[38] = q_[38]; 
  assign q[39] = q_[39]; 
  assign q[40] = q_[40]; 
  assign q[41] = q_[41]; 
  assign q[42] = q_[42]; 
  assign q[43] = q_[43]; 
  assign q[44] = q_[44]; 
  assign q[45] = q_[45]; 
  assign q[46] = q_[46]; 
  assign q[47] = q_[47]; 
  assign q[48] = q_[48]; 
  assign q[49] = q_[49]; 
  assign q[50] = q_[50]; 
  assign q[51] = q_[51]; 
  assign q[52] = q_[52]; 
  assign q[53] = q_[53]; 
  assign q[54] = q_[54]; 
  assign q[55] = q_[55]; 
  assign q[56] = q_[56]; 
  assign q[57] = q_[57]; 
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
  assign ret1n_ = ret1n;

   `ifdef ARM_FAULT_MODELING
     rf128x128_error_injection u1(.CLK(clk_), .Q_out(q_), .A(a_int), .CEN(cen_int), .GWEN(gwen_int), .WEN(wen_int), .Q_in(q_int));
  `else
  assign `ARM_UD_SEQ q_ = (ret1n_ | pre_charge_st) & ~corrupt_power ? ((q_int)) : {128{1'bx}};
  `endif

// If INITIALIZE_MEMORY is defined at Simulator Command Line, it Initializes the Memory with all ZEROS.
`ifdef INITIALIZE_MEMORY
  integer i;
  initial begin
    #0;
    for (i = 0; i < MEM_HEIGHT; i = i + 1)
      mem[i] = {MEM_WIDTH{1'b0}};
  end
`endif
  always @ (posedge clk_  ) begin
      if(ema_ !== ARM_REF_EMA_VALUE && (ARM_LOCAL_DISABLE_EMA_CHECK == 0) &&  (((cen_int === 1'b0 &&  clk_ === 1'b1) ) && ret1n_ === 1'b1  )) 
      $display("Warning: Set Value for ema is %d and is not equal to %d in %m at %0t. Please refer README for correct value of ema", ema_, ARM_REF_EMA_VALUE, $time);
  end
  always @ (posedge clk_ ) begin
      if(emaw_ !== ARM_REF_EMAW_VALUE && (ARM_LOCAL_DISABLE_EMA_CHECK == 0) &&  (((cen_int === 1'b0 &&  clk_ === 1'b1) ) && ret1n_ === 1'b1  )) 
      $display("Warning: Set Value for emaw is %d and is not equal to %d in %m at %0t. Please refer README for correct value of emaw", emaw_, ARM_REF_EMAW_VALUE, $time);
  end
  always @ (posedge clk_  ) begin
      if(emas_ !== ARM_REF_EMAS_VALUE  && (ARM_LOCAL_DISABLE_EMA_CHECK == 0) &&  (((cen_int === 1'b0 &&  clk_ === 1'b1) ) && ret1n_ === 1'b1  )) 
      $display("Warning: Set Value for emas is %d and is not equal to %d in %m at %0t. Please refer README for correct value of emas", emas_, ARM_REF_EMAS_VALUE, $time);
  end

  task failedWrite;
  input port_f;
  integer i;
  begin
    for (i = 0; i < MEM_HEIGHT; i = i + 1)
      mem[i] = {MEM_WIDTH{1'bx}};
  end
  endtask

  function isBitX;
    input bitval;
    begin
      isBitX = ( bitval===1'bx || bitval===1'bz ) ? 1'b1 : 1'b0;
    end
  endfunction


task loadmem;
	input [1000*8-1:0] filename;
	reg [BITS-1:0] memld [0:WORDS-1];
	integer i;
	reg [BITS-1:0] wordtemp;
	reg [6:0] Atemp;
  begin
	$readmemb(filename, memld);
`ifdef ARM_BACKDOOR_NOCEN
`else
	if (cen_ === 1'b1) begin
`endif
	  for (i=0;i<WORDS;i=i+1) begin
	  wordtemp = memld[i];
	  Atemp = i;
	  mux_address = (Atemp & 1'b1);
      row_address = (Atemp >> 1);
      row = mem[row_address];
        writeEnable = {128{1'b1}};
        row_mask =  ( {1'b0, writeEnable[127], 1'b0, writeEnable[126], 1'b0, writeEnable[125],
          1'b0, writeEnable[124], 1'b0, writeEnable[123], 1'b0, writeEnable[122], 1'b0, writeEnable[121],
          1'b0, writeEnable[120], 1'b0, writeEnable[119], 1'b0, writeEnable[118], 1'b0, writeEnable[117],
          1'b0, writeEnable[116], 1'b0, writeEnable[115], 1'b0, writeEnable[114], 1'b0, writeEnable[113],
          1'b0, writeEnable[112], 1'b0, writeEnable[111], 1'b0, writeEnable[110], 1'b0, writeEnable[109],
          1'b0, writeEnable[108], 1'b0, writeEnable[107], 1'b0, writeEnable[106], 1'b0, writeEnable[105],
          1'b0, writeEnable[104], 1'b0, writeEnable[103], 1'b0, writeEnable[102], 1'b0, writeEnable[101],
          1'b0, writeEnable[100], 1'b0, writeEnable[99], 1'b0, writeEnable[98], 1'b0, writeEnable[97],
          1'b0, writeEnable[96], 1'b0, writeEnable[95], 1'b0, writeEnable[94], 1'b0, writeEnable[93],
          1'b0, writeEnable[92], 1'b0, writeEnable[91], 1'b0, writeEnable[90], 1'b0, writeEnable[89],
          1'b0, writeEnable[88], 1'b0, writeEnable[87], 1'b0, writeEnable[86], 1'b0, writeEnable[85],
          1'b0, writeEnable[84], 1'b0, writeEnable[83], 1'b0, writeEnable[82], 1'b0, writeEnable[81],
          1'b0, writeEnable[80], 1'b0, writeEnable[79], 1'b0, writeEnable[78], 1'b0, writeEnable[77],
          1'b0, writeEnable[76], 1'b0, writeEnable[75], 1'b0, writeEnable[74], 1'b0, writeEnable[73],
          1'b0, writeEnable[72], 1'b0, writeEnable[71], 1'b0, writeEnable[70], 1'b0, writeEnable[69],
          1'b0, writeEnable[68], 1'b0, writeEnable[67], 1'b0, writeEnable[66], 1'b0, writeEnable[65],
          1'b0, writeEnable[64], 1'b0, writeEnable[63], 1'b0, writeEnable[62], 1'b0, writeEnable[61],
          1'b0, writeEnable[60], 1'b0, writeEnable[59], 1'b0, writeEnable[58], 1'b0, writeEnable[57],
          1'b0, writeEnable[56], 1'b0, writeEnable[55], 1'b0, writeEnable[54], 1'b0, writeEnable[53],
          1'b0, writeEnable[52], 1'b0, writeEnable[51], 1'b0, writeEnable[50], 1'b0, writeEnable[49],
          1'b0, writeEnable[48], 1'b0, writeEnable[47], 1'b0, writeEnable[46], 1'b0, writeEnable[45],
          1'b0, writeEnable[44], 1'b0, writeEnable[43], 1'b0, writeEnable[42], 1'b0, writeEnable[41],
          1'b0, writeEnable[40], 1'b0, writeEnable[39], 1'b0, writeEnable[38], 1'b0, writeEnable[37],
          1'b0, writeEnable[36], 1'b0, writeEnable[35], 1'b0, writeEnable[34], 1'b0, writeEnable[33],
          1'b0, writeEnable[32], 1'b0, writeEnable[31], 1'b0, writeEnable[30], 1'b0, writeEnable[29],
          1'b0, writeEnable[28], 1'b0, writeEnable[27], 1'b0, writeEnable[26], 1'b0, writeEnable[25],
          1'b0, writeEnable[24], 1'b0, writeEnable[23], 1'b0, writeEnable[22], 1'b0, writeEnable[21],
          1'b0, writeEnable[20], 1'b0, writeEnable[19], 1'b0, writeEnable[18], 1'b0, writeEnable[17],
          1'b0, writeEnable[16], 1'b0, writeEnable[15], 1'b0, writeEnable[14], 1'b0, writeEnable[13],
          1'b0, writeEnable[12], 1'b0, writeEnable[11], 1'b0, writeEnable[10], 1'b0, writeEnable[9],
          1'b0, writeEnable[8], 1'b0, writeEnable[7], 1'b0, writeEnable[6], 1'b0, writeEnable[5],
          1'b0, writeEnable[4], 1'b0, writeEnable[3], 1'b0, writeEnable[2], 1'b0, writeEnable[1],
          1'b0, writeEnable[0]} << mux_address);
        new_data =  ( {1'b0, wordtemp[127], 1'b0, wordtemp[126], 1'b0, wordtemp[125],
          1'b0, wordtemp[124], 1'b0, wordtemp[123], 1'b0, wordtemp[122], 1'b0, wordtemp[121],
          1'b0, wordtemp[120], 1'b0, wordtemp[119], 1'b0, wordtemp[118], 1'b0, wordtemp[117],
          1'b0, wordtemp[116], 1'b0, wordtemp[115], 1'b0, wordtemp[114], 1'b0, wordtemp[113],
          1'b0, wordtemp[112], 1'b0, wordtemp[111], 1'b0, wordtemp[110], 1'b0, wordtemp[109],
          1'b0, wordtemp[108], 1'b0, wordtemp[107], 1'b0, wordtemp[106], 1'b0, wordtemp[105],
          1'b0, wordtemp[104], 1'b0, wordtemp[103], 1'b0, wordtemp[102], 1'b0, wordtemp[101],
          1'b0, wordtemp[100], 1'b0, wordtemp[99], 1'b0, wordtemp[98], 1'b0, wordtemp[97],
          1'b0, wordtemp[96], 1'b0, wordtemp[95], 1'b0, wordtemp[94], 1'b0, wordtemp[93],
          1'b0, wordtemp[92], 1'b0, wordtemp[91], 1'b0, wordtemp[90], 1'b0, wordtemp[89],
          1'b0, wordtemp[88], 1'b0, wordtemp[87], 1'b0, wordtemp[86], 1'b0, wordtemp[85],
          1'b0, wordtemp[84], 1'b0, wordtemp[83], 1'b0, wordtemp[82], 1'b0, wordtemp[81],
          1'b0, wordtemp[80], 1'b0, wordtemp[79], 1'b0, wordtemp[78], 1'b0, wordtemp[77],
          1'b0, wordtemp[76], 1'b0, wordtemp[75], 1'b0, wordtemp[74], 1'b0, wordtemp[73],
          1'b0, wordtemp[72], 1'b0, wordtemp[71], 1'b0, wordtemp[70], 1'b0, wordtemp[69],
          1'b0, wordtemp[68], 1'b0, wordtemp[67], 1'b0, wordtemp[66], 1'b0, wordtemp[65],
          1'b0, wordtemp[64], 1'b0, wordtemp[63], 1'b0, wordtemp[62], 1'b0, wordtemp[61],
          1'b0, wordtemp[60], 1'b0, wordtemp[59], 1'b0, wordtemp[58], 1'b0, wordtemp[57],
          1'b0, wordtemp[56], 1'b0, wordtemp[55], 1'b0, wordtemp[54], 1'b0, wordtemp[53],
          1'b0, wordtemp[52], 1'b0, wordtemp[51], 1'b0, wordtemp[50], 1'b0, wordtemp[49],
          1'b0, wordtemp[48], 1'b0, wordtemp[47], 1'b0, wordtemp[46], 1'b0, wordtemp[45],
          1'b0, wordtemp[44], 1'b0, wordtemp[43], 1'b0, wordtemp[42], 1'b0, wordtemp[41],
          1'b0, wordtemp[40], 1'b0, wordtemp[39], 1'b0, wordtemp[38], 1'b0, wordtemp[37],
          1'b0, wordtemp[36], 1'b0, wordtemp[35], 1'b0, wordtemp[34], 1'b0, wordtemp[33],
          1'b0, wordtemp[32], 1'b0, wordtemp[31], 1'b0, wordtemp[30], 1'b0, wordtemp[29],
          1'b0, wordtemp[28], 1'b0, wordtemp[27], 1'b0, wordtemp[26], 1'b0, wordtemp[25],
          1'b0, wordtemp[24], 1'b0, wordtemp[23], 1'b0, wordtemp[22], 1'b0, wordtemp[21],
          1'b0, wordtemp[20], 1'b0, wordtemp[19], 1'b0, wordtemp[18], 1'b0, wordtemp[17],
          1'b0, wordtemp[16], 1'b0, wordtemp[15], 1'b0, wordtemp[14], 1'b0, wordtemp[13],
          1'b0, wordtemp[12], 1'b0, wordtemp[11], 1'b0, wordtemp[10], 1'b0, wordtemp[9],
          1'b0, wordtemp[8], 1'b0, wordtemp[7], 1'b0, wordtemp[6], 1'b0, wordtemp[5],
          1'b0, wordtemp[4], 1'b0, wordtemp[3], 1'b0, wordtemp[2], 1'b0, wordtemp[1],
          1'b0, wordtemp[0]} << mux_address);
        row = (row & ~row_mask) | (row_mask & (~row_mask | new_data));
        mem[row_address] = row;
`ifdef ARM_BACKDOOR_NOCEN
`else
  	end
`endif
  	end
  end
  endtask

task dumpmem;
	input [1000*8-1:0] filename_dump;
	integer i, dump_file_desc;
	reg [BITS-1:0] wordtemp;
	reg [6:0] Atemp;
  begin
	dump_file_desc = $fopen(filename_dump);
`ifdef ARM_BACKDOOR_NOCEN
`else
	if (cen_ === 1'b1) begin
`endif
	  for (i=0;i<WORDS;i=i+1) begin
	  Atemp = i;
	  mux_address = (Atemp & 1'b1);
      row_address = (Atemp >> 1);
      row = mem[row_address];
        writeEnable = {128{1'b1}};
        data_out = (row >> (mux_address));
        readLatch0 = {data_out[254], data_out[252], data_out[250], data_out[248], data_out[246],
          data_out[244], data_out[242], data_out[240], data_out[238], data_out[236],
          data_out[234], data_out[232], data_out[230], data_out[228], data_out[226],
          data_out[224], data_out[222], data_out[220], data_out[218], data_out[216],
          data_out[214], data_out[212], data_out[210], data_out[208], data_out[206],
          data_out[204], data_out[202], data_out[200], data_out[198], data_out[196],
          data_out[194], data_out[192], data_out[190], data_out[188], data_out[186],
          data_out[184], data_out[182], data_out[180], data_out[178], data_out[176],
          data_out[174], data_out[172], data_out[170], data_out[168], data_out[166],
          data_out[164], data_out[162], data_out[160], data_out[158], data_out[156],
          data_out[154], data_out[152], data_out[150], data_out[148], data_out[146],
          data_out[144], data_out[142], data_out[140], data_out[138], data_out[136],
          data_out[134], data_out[132], data_out[130], data_out[128], data_out[126],
          data_out[124], data_out[122], data_out[120], data_out[118], data_out[116],
          data_out[114], data_out[112], data_out[110], data_out[108], data_out[106],
          data_out[104], data_out[102], data_out[100], data_out[98], data_out[96],
          data_out[94], data_out[92], data_out[90], data_out[88], data_out[86], data_out[84],
          data_out[82], data_out[80], data_out[78], data_out[76], data_out[74], data_out[72],
          data_out[70], data_out[68], data_out[66], data_out[64], data_out[62], data_out[60],
          data_out[58], data_out[56], data_out[54], data_out[52], data_out[50], data_out[48],
          data_out[46], data_out[44], data_out[42], data_out[40], data_out[38], data_out[36],
          data_out[34], data_out[32], data_out[30], data_out[28], data_out[26], data_out[24],
          data_out[22], data_out[20], data_out[18], data_out[16], data_out[14], data_out[12],
          data_out[10], data_out[8], data_out[6], data_out[4], data_out[2], data_out[0]};
        shifted_readLatch0 = readLatch0;
        q_int = {shifted_readLatch0[127], shifted_readLatch0[126], shifted_readLatch0[125],
          shifted_readLatch0[124], shifted_readLatch0[123], shifted_readLatch0[122],
          shifted_readLatch0[121], shifted_readLatch0[120], shifted_readLatch0[119],
          shifted_readLatch0[118], shifted_readLatch0[117], shifted_readLatch0[116],
          shifted_readLatch0[115], shifted_readLatch0[114], shifted_readLatch0[113],
          shifted_readLatch0[112], shifted_readLatch0[111], shifted_readLatch0[110],
          shifted_readLatch0[109], shifted_readLatch0[108], shifted_readLatch0[107],
          shifted_readLatch0[106], shifted_readLatch0[105], shifted_readLatch0[104],
          shifted_readLatch0[103], shifted_readLatch0[102], shifted_readLatch0[101],
          shifted_readLatch0[100], shifted_readLatch0[99], shifted_readLatch0[98],
          shifted_readLatch0[97], shifted_readLatch0[96], shifted_readLatch0[95], shifted_readLatch0[94],
          shifted_readLatch0[93], shifted_readLatch0[92], shifted_readLatch0[91], shifted_readLatch0[90],
          shifted_readLatch0[89], shifted_readLatch0[88], shifted_readLatch0[87], shifted_readLatch0[86],
          shifted_readLatch0[85], shifted_readLatch0[84], shifted_readLatch0[83], shifted_readLatch0[82],
          shifted_readLatch0[81], shifted_readLatch0[80], shifted_readLatch0[79], shifted_readLatch0[78],
          shifted_readLatch0[77], shifted_readLatch0[76], shifted_readLatch0[75], shifted_readLatch0[74],
          shifted_readLatch0[73], shifted_readLatch0[72], shifted_readLatch0[71], shifted_readLatch0[70],
          shifted_readLatch0[69], shifted_readLatch0[68], shifted_readLatch0[67], shifted_readLatch0[66],
          shifted_readLatch0[65], shifted_readLatch0[64], shifted_readLatch0[63], shifted_readLatch0[62],
          shifted_readLatch0[61], shifted_readLatch0[60], shifted_readLatch0[59], shifted_readLatch0[58],
          shifted_readLatch0[57], shifted_readLatch0[56], shifted_readLatch0[55], shifted_readLatch0[54],
          shifted_readLatch0[53], shifted_readLatch0[52], shifted_readLatch0[51], shifted_readLatch0[50],
          shifted_readLatch0[49], shifted_readLatch0[48], shifted_readLatch0[47], shifted_readLatch0[46],
          shifted_readLatch0[45], shifted_readLatch0[44], shifted_readLatch0[43], shifted_readLatch0[42],
          shifted_readLatch0[41], shifted_readLatch0[40], shifted_readLatch0[39], shifted_readLatch0[38],
          shifted_readLatch0[37], shifted_readLatch0[36], shifted_readLatch0[35], shifted_readLatch0[34],
          shifted_readLatch0[33], shifted_readLatch0[32], shifted_readLatch0[31], shifted_readLatch0[30],
          shifted_readLatch0[29], shifted_readLatch0[28], shifted_readLatch0[27], shifted_readLatch0[26],
          shifted_readLatch0[25], shifted_readLatch0[24], shifted_readLatch0[23], shifted_readLatch0[22],
          shifted_readLatch0[21], shifted_readLatch0[20], shifted_readLatch0[19], shifted_readLatch0[18],
          shifted_readLatch0[17], shifted_readLatch0[16], shifted_readLatch0[15], shifted_readLatch0[14],
          shifted_readLatch0[13], shifted_readLatch0[12], shifted_readLatch0[11], shifted_readLatch0[10],
          shifted_readLatch0[9], shifted_readLatch0[8], shifted_readLatch0[7], shifted_readLatch0[6],
          shifted_readLatch0[5], shifted_readLatch0[4], shifted_readLatch0[3], shifted_readLatch0[2],
          shifted_readLatch0[1], shifted_readLatch0[0]};
   	$fdisplay(dump_file_desc, "%b", q_int);
  end
`ifdef ARM_BACKDOOR_NOCEN
`else
  	end
`endif
    $fclose(dump_file_desc);
  end
  endtask

task loadaddr;
	input [6:0] load_addr;
	input [127:0] load_data;
	reg [BITS-1:0] wordtemp;
	reg [6:0] Atemp;
  begin
`ifdef ARM_BACKDOOR_NOCEN
`else
	if (cen_ === 1'b1) begin
`endif
	  wordtemp = load_data;
	  Atemp = load_addr;
	  mux_address = (Atemp & 1'b1);
      row_address = (Atemp >> 1);
      row = mem[row_address];
        writeEnable = {128{1'b1}};
        row_mask =  ( {1'b0, writeEnable[127], 1'b0, writeEnable[126], 1'b0, writeEnable[125],
          1'b0, writeEnable[124], 1'b0, writeEnable[123], 1'b0, writeEnable[122], 1'b0, writeEnable[121],
          1'b0, writeEnable[120], 1'b0, writeEnable[119], 1'b0, writeEnable[118], 1'b0, writeEnable[117],
          1'b0, writeEnable[116], 1'b0, writeEnable[115], 1'b0, writeEnable[114], 1'b0, writeEnable[113],
          1'b0, writeEnable[112], 1'b0, writeEnable[111], 1'b0, writeEnable[110], 1'b0, writeEnable[109],
          1'b0, writeEnable[108], 1'b0, writeEnable[107], 1'b0, writeEnable[106], 1'b0, writeEnable[105],
          1'b0, writeEnable[104], 1'b0, writeEnable[103], 1'b0, writeEnable[102], 1'b0, writeEnable[101],
          1'b0, writeEnable[100], 1'b0, writeEnable[99], 1'b0, writeEnable[98], 1'b0, writeEnable[97],
          1'b0, writeEnable[96], 1'b0, writeEnable[95], 1'b0, writeEnable[94], 1'b0, writeEnable[93],
          1'b0, writeEnable[92], 1'b0, writeEnable[91], 1'b0, writeEnable[90], 1'b0, writeEnable[89],
          1'b0, writeEnable[88], 1'b0, writeEnable[87], 1'b0, writeEnable[86], 1'b0, writeEnable[85],
          1'b0, writeEnable[84], 1'b0, writeEnable[83], 1'b0, writeEnable[82], 1'b0, writeEnable[81],
          1'b0, writeEnable[80], 1'b0, writeEnable[79], 1'b0, writeEnable[78], 1'b0, writeEnable[77],
          1'b0, writeEnable[76], 1'b0, writeEnable[75], 1'b0, writeEnable[74], 1'b0, writeEnable[73],
          1'b0, writeEnable[72], 1'b0, writeEnable[71], 1'b0, writeEnable[70], 1'b0, writeEnable[69],
          1'b0, writeEnable[68], 1'b0, writeEnable[67], 1'b0, writeEnable[66], 1'b0, writeEnable[65],
          1'b0, writeEnable[64], 1'b0, writeEnable[63], 1'b0, writeEnable[62], 1'b0, writeEnable[61],
          1'b0, writeEnable[60], 1'b0, writeEnable[59], 1'b0, writeEnable[58], 1'b0, writeEnable[57],
          1'b0, writeEnable[56], 1'b0, writeEnable[55], 1'b0, writeEnable[54], 1'b0, writeEnable[53],
          1'b0, writeEnable[52], 1'b0, writeEnable[51], 1'b0, writeEnable[50], 1'b0, writeEnable[49],
          1'b0, writeEnable[48], 1'b0, writeEnable[47], 1'b0, writeEnable[46], 1'b0, writeEnable[45],
          1'b0, writeEnable[44], 1'b0, writeEnable[43], 1'b0, writeEnable[42], 1'b0, writeEnable[41],
          1'b0, writeEnable[40], 1'b0, writeEnable[39], 1'b0, writeEnable[38], 1'b0, writeEnable[37],
          1'b0, writeEnable[36], 1'b0, writeEnable[35], 1'b0, writeEnable[34], 1'b0, writeEnable[33],
          1'b0, writeEnable[32], 1'b0, writeEnable[31], 1'b0, writeEnable[30], 1'b0, writeEnable[29],
          1'b0, writeEnable[28], 1'b0, writeEnable[27], 1'b0, writeEnable[26], 1'b0, writeEnable[25],
          1'b0, writeEnable[24], 1'b0, writeEnable[23], 1'b0, writeEnable[22], 1'b0, writeEnable[21],
          1'b0, writeEnable[20], 1'b0, writeEnable[19], 1'b0, writeEnable[18], 1'b0, writeEnable[17],
          1'b0, writeEnable[16], 1'b0, writeEnable[15], 1'b0, writeEnable[14], 1'b0, writeEnable[13],
          1'b0, writeEnable[12], 1'b0, writeEnable[11], 1'b0, writeEnable[10], 1'b0, writeEnable[9],
          1'b0, writeEnable[8], 1'b0, writeEnable[7], 1'b0, writeEnable[6], 1'b0, writeEnable[5],
          1'b0, writeEnable[4], 1'b0, writeEnable[3], 1'b0, writeEnable[2], 1'b0, writeEnable[1],
          1'b0, writeEnable[0]} << mux_address);
        new_data =  ( {1'b0, wordtemp[127], 1'b0, wordtemp[126], 1'b0, wordtemp[125],
          1'b0, wordtemp[124], 1'b0, wordtemp[123], 1'b0, wordtemp[122], 1'b0, wordtemp[121],
          1'b0, wordtemp[120], 1'b0, wordtemp[119], 1'b0, wordtemp[118], 1'b0, wordtemp[117],
          1'b0, wordtemp[116], 1'b0, wordtemp[115], 1'b0, wordtemp[114], 1'b0, wordtemp[113],
          1'b0, wordtemp[112], 1'b0, wordtemp[111], 1'b0, wordtemp[110], 1'b0, wordtemp[109],
          1'b0, wordtemp[108], 1'b0, wordtemp[107], 1'b0, wordtemp[106], 1'b0, wordtemp[105],
          1'b0, wordtemp[104], 1'b0, wordtemp[103], 1'b0, wordtemp[102], 1'b0, wordtemp[101],
          1'b0, wordtemp[100], 1'b0, wordtemp[99], 1'b0, wordtemp[98], 1'b0, wordtemp[97],
          1'b0, wordtemp[96], 1'b0, wordtemp[95], 1'b0, wordtemp[94], 1'b0, wordtemp[93],
          1'b0, wordtemp[92], 1'b0, wordtemp[91], 1'b0, wordtemp[90], 1'b0, wordtemp[89],
          1'b0, wordtemp[88], 1'b0, wordtemp[87], 1'b0, wordtemp[86], 1'b0, wordtemp[85],
          1'b0, wordtemp[84], 1'b0, wordtemp[83], 1'b0, wordtemp[82], 1'b0, wordtemp[81],
          1'b0, wordtemp[80], 1'b0, wordtemp[79], 1'b0, wordtemp[78], 1'b0, wordtemp[77],
          1'b0, wordtemp[76], 1'b0, wordtemp[75], 1'b0, wordtemp[74], 1'b0, wordtemp[73],
          1'b0, wordtemp[72], 1'b0, wordtemp[71], 1'b0, wordtemp[70], 1'b0, wordtemp[69],
          1'b0, wordtemp[68], 1'b0, wordtemp[67], 1'b0, wordtemp[66], 1'b0, wordtemp[65],
          1'b0, wordtemp[64], 1'b0, wordtemp[63], 1'b0, wordtemp[62], 1'b0, wordtemp[61],
          1'b0, wordtemp[60], 1'b0, wordtemp[59], 1'b0, wordtemp[58], 1'b0, wordtemp[57],
          1'b0, wordtemp[56], 1'b0, wordtemp[55], 1'b0, wordtemp[54], 1'b0, wordtemp[53],
          1'b0, wordtemp[52], 1'b0, wordtemp[51], 1'b0, wordtemp[50], 1'b0, wordtemp[49],
          1'b0, wordtemp[48], 1'b0, wordtemp[47], 1'b0, wordtemp[46], 1'b0, wordtemp[45],
          1'b0, wordtemp[44], 1'b0, wordtemp[43], 1'b0, wordtemp[42], 1'b0, wordtemp[41],
          1'b0, wordtemp[40], 1'b0, wordtemp[39], 1'b0, wordtemp[38], 1'b0, wordtemp[37],
          1'b0, wordtemp[36], 1'b0, wordtemp[35], 1'b0, wordtemp[34], 1'b0, wordtemp[33],
          1'b0, wordtemp[32], 1'b0, wordtemp[31], 1'b0, wordtemp[30], 1'b0, wordtemp[29],
          1'b0, wordtemp[28], 1'b0, wordtemp[27], 1'b0, wordtemp[26], 1'b0, wordtemp[25],
          1'b0, wordtemp[24], 1'b0, wordtemp[23], 1'b0, wordtemp[22], 1'b0, wordtemp[21],
          1'b0, wordtemp[20], 1'b0, wordtemp[19], 1'b0, wordtemp[18], 1'b0, wordtemp[17],
          1'b0, wordtemp[16], 1'b0, wordtemp[15], 1'b0, wordtemp[14], 1'b0, wordtemp[13],
          1'b0, wordtemp[12], 1'b0, wordtemp[11], 1'b0, wordtemp[10], 1'b0, wordtemp[9],
          1'b0, wordtemp[8], 1'b0, wordtemp[7], 1'b0, wordtemp[6], 1'b0, wordtemp[5],
          1'b0, wordtemp[4], 1'b0, wordtemp[3], 1'b0, wordtemp[2], 1'b0, wordtemp[1],
          1'b0, wordtemp[0]} << mux_address);
        row = (row & ~row_mask) | (row_mask & (~row_mask | new_data));
        mem[row_address] = row;
`ifdef ARM_BACKDOOR_NOCEN
`else
  	end
`endif
  	end
  endtask

task dumpaddr;
	output [127:0] dump_data;
	input [6:0] dump_addr;
	reg [BITS-1:0] wordtemp;
	reg [6:0] Atemp;
  begin
`ifdef ARM_BACKDOOR_NOCEN
`else
	if (cen_ === 1'b1) begin
`endif
	  Atemp = dump_addr;
	  mux_address = (Atemp & 1'b1);
      row_address = (Atemp >> 1);
      row = mem[row_address];
        writeEnable = {128{1'b1}};
        data_out = (row >> (mux_address));
        readLatch0 = {data_out[254], data_out[252], data_out[250], data_out[248], data_out[246],
          data_out[244], data_out[242], data_out[240], data_out[238], data_out[236],
          data_out[234], data_out[232], data_out[230], data_out[228], data_out[226],
          data_out[224], data_out[222], data_out[220], data_out[218], data_out[216],
          data_out[214], data_out[212], data_out[210], data_out[208], data_out[206],
          data_out[204], data_out[202], data_out[200], data_out[198], data_out[196],
          data_out[194], data_out[192], data_out[190], data_out[188], data_out[186],
          data_out[184], data_out[182], data_out[180], data_out[178], data_out[176],
          data_out[174], data_out[172], data_out[170], data_out[168], data_out[166],
          data_out[164], data_out[162], data_out[160], data_out[158], data_out[156],
          data_out[154], data_out[152], data_out[150], data_out[148], data_out[146],
          data_out[144], data_out[142], data_out[140], data_out[138], data_out[136],
          data_out[134], data_out[132], data_out[130], data_out[128], data_out[126],
          data_out[124], data_out[122], data_out[120], data_out[118], data_out[116],
          data_out[114], data_out[112], data_out[110], data_out[108], data_out[106],
          data_out[104], data_out[102], data_out[100], data_out[98], data_out[96],
          data_out[94], data_out[92], data_out[90], data_out[88], data_out[86], data_out[84],
          data_out[82], data_out[80], data_out[78], data_out[76], data_out[74], data_out[72],
          data_out[70], data_out[68], data_out[66], data_out[64], data_out[62], data_out[60],
          data_out[58], data_out[56], data_out[54], data_out[52], data_out[50], data_out[48],
          data_out[46], data_out[44], data_out[42], data_out[40], data_out[38], data_out[36],
          data_out[34], data_out[32], data_out[30], data_out[28], data_out[26], data_out[24],
          data_out[22], data_out[20], data_out[18], data_out[16], data_out[14], data_out[12],
          data_out[10], data_out[8], data_out[6], data_out[4], data_out[2], data_out[0]};
        shifted_readLatch0 = readLatch0;
        q_int = {shifted_readLatch0[127], shifted_readLatch0[126], shifted_readLatch0[125],
          shifted_readLatch0[124], shifted_readLatch0[123], shifted_readLatch0[122],
          shifted_readLatch0[121], shifted_readLatch0[120], shifted_readLatch0[119],
          shifted_readLatch0[118], shifted_readLatch0[117], shifted_readLatch0[116],
          shifted_readLatch0[115], shifted_readLatch0[114], shifted_readLatch0[113],
          shifted_readLatch0[112], shifted_readLatch0[111], shifted_readLatch0[110],
          shifted_readLatch0[109], shifted_readLatch0[108], shifted_readLatch0[107],
          shifted_readLatch0[106], shifted_readLatch0[105], shifted_readLatch0[104],
          shifted_readLatch0[103], shifted_readLatch0[102], shifted_readLatch0[101],
          shifted_readLatch0[100], shifted_readLatch0[99], shifted_readLatch0[98],
          shifted_readLatch0[97], shifted_readLatch0[96], shifted_readLatch0[95], shifted_readLatch0[94],
          shifted_readLatch0[93], shifted_readLatch0[92], shifted_readLatch0[91], shifted_readLatch0[90],
          shifted_readLatch0[89], shifted_readLatch0[88], shifted_readLatch0[87], shifted_readLatch0[86],
          shifted_readLatch0[85], shifted_readLatch0[84], shifted_readLatch0[83], shifted_readLatch0[82],
          shifted_readLatch0[81], shifted_readLatch0[80], shifted_readLatch0[79], shifted_readLatch0[78],
          shifted_readLatch0[77], shifted_readLatch0[76], shifted_readLatch0[75], shifted_readLatch0[74],
          shifted_readLatch0[73], shifted_readLatch0[72], shifted_readLatch0[71], shifted_readLatch0[70],
          shifted_readLatch0[69], shifted_readLatch0[68], shifted_readLatch0[67], shifted_readLatch0[66],
          shifted_readLatch0[65], shifted_readLatch0[64], shifted_readLatch0[63], shifted_readLatch0[62],
          shifted_readLatch0[61], shifted_readLatch0[60], shifted_readLatch0[59], shifted_readLatch0[58],
          shifted_readLatch0[57], shifted_readLatch0[56], shifted_readLatch0[55], shifted_readLatch0[54],
          shifted_readLatch0[53], shifted_readLatch0[52], shifted_readLatch0[51], shifted_readLatch0[50],
          shifted_readLatch0[49], shifted_readLatch0[48], shifted_readLatch0[47], shifted_readLatch0[46],
          shifted_readLatch0[45], shifted_readLatch0[44], shifted_readLatch0[43], shifted_readLatch0[42],
          shifted_readLatch0[41], shifted_readLatch0[40], shifted_readLatch0[39], shifted_readLatch0[38],
          shifted_readLatch0[37], shifted_readLatch0[36], shifted_readLatch0[35], shifted_readLatch0[34],
          shifted_readLatch0[33], shifted_readLatch0[32], shifted_readLatch0[31], shifted_readLatch0[30],
          shifted_readLatch0[29], shifted_readLatch0[28], shifted_readLatch0[27], shifted_readLatch0[26],
          shifted_readLatch0[25], shifted_readLatch0[24], shifted_readLatch0[23], shifted_readLatch0[22],
          shifted_readLatch0[21], shifted_readLatch0[20], shifted_readLatch0[19], shifted_readLatch0[18],
          shifted_readLatch0[17], shifted_readLatch0[16], shifted_readLatch0[15], shifted_readLatch0[14],
          shifted_readLatch0[13], shifted_readLatch0[12], shifted_readLatch0[11], shifted_readLatch0[10],
          shifted_readLatch0[9], shifted_readLatch0[8], shifted_readLatch0[7], shifted_readLatch0[6],
          shifted_readLatch0[5], shifted_readLatch0[4], shifted_readLatch0[3], shifted_readLatch0[2],
          shifted_readLatch0[1], shifted_readLatch0[0]};
   	dump_data = q_int;
`ifdef ARM_BACKDOOR_NOCEN
`else
  	end
`endif
  end
  endtask


  task readWrite;
  begin
    if (ret1n_int === 1'bx || ret1n_int === 1'bz) begin
      failedWrite(0);
        q_int = {128{1'bx}};
    end else if (ret1n_int === 1'b0 && cen_int === 1'b0) begin
      failedWrite(0);
        q_int = {128{1'bx}};
    end else if (ret1n_int === 1'b0) begin
      // no cycle in retention mode
    end else if (^{cen_int, ema_int, emaw_int, emas_int, ret1n_int} === 1'bx) begin
      failedWrite(0);
        q_int = {128{1'bx}};
    end else if ((a_int >= WORDS) && (cen_int === 1'b0)) begin
      q_int = gwen_int !== 1'b1 ? q_int : {128{1'bx}};
    end else if (cen_int === 1'b0 && (^a_int) === 1'bx) begin
     if (gwen_int !== 1)
      failedWrite(0);
        q_int = {128{1'bx}};
    end else if (cen_int === 1'b0) begin
      mux_address = (a_int & 1'b1);
      row_address = (a_int >> 1);
      if (row_address > 63)
        row = {256{1'bx}};
      else
        row = mem[row_address];
      if( isBitX(gwen_int) ) begin
        writeEnable = {128{1'bx}};
        d_int = {128{1'bx}};
      end else
          writeEnable = ~ ( {128{gwen_int}} | {wen_int[127], wen_int[126], wen_int[125],
          wen_int[124], wen_int[123], wen_int[122], wen_int[121], wen_int[120], wen_int[119],
          wen_int[118], wen_int[117], wen_int[116], wen_int[115], wen_int[114], wen_int[113],
          wen_int[112], wen_int[111], wen_int[110], wen_int[109], wen_int[108], wen_int[107],
          wen_int[106], wen_int[105], wen_int[104], wen_int[103], wen_int[102], wen_int[101],
          wen_int[100], wen_int[99], wen_int[98], wen_int[97], wen_int[96], wen_int[95],
          wen_int[94], wen_int[93], wen_int[92], wen_int[91], wen_int[90], wen_int[89],
          wen_int[88], wen_int[87], wen_int[86], wen_int[85], wen_int[84], wen_int[83],
          wen_int[82], wen_int[81], wen_int[80], wen_int[79], wen_int[78], wen_int[77],
          wen_int[76], wen_int[75], wen_int[74], wen_int[73], wen_int[72], wen_int[71],
          wen_int[70], wen_int[69], wen_int[68], wen_int[67], wen_int[66], wen_int[65],
          wen_int[64], wen_int[63], wen_int[62], wen_int[61], wen_int[60], wen_int[59],
          wen_int[58], wen_int[57], wen_int[56], wen_int[55], wen_int[54], wen_int[53],
          wen_int[52], wen_int[51], wen_int[50], wen_int[49], wen_int[48], wen_int[47],
          wen_int[46], wen_int[45], wen_int[44], wen_int[43], wen_int[42], wen_int[41],
          wen_int[40], wen_int[39], wen_int[38], wen_int[37], wen_int[36], wen_int[35],
          wen_int[34], wen_int[33], wen_int[32], wen_int[31], wen_int[30], wen_int[29],
          wen_int[28], wen_int[27], wen_int[26], wen_int[25], wen_int[24], wen_int[23],
          wen_int[22], wen_int[21], wen_int[20], wen_int[19], wen_int[18], wen_int[17],
          wen_int[16], wen_int[15], wen_int[14], wen_int[13], wen_int[12], wen_int[11],
          wen_int[10], wen_int[9], wen_int[8], wen_int[7], wen_int[6], wen_int[5],
          wen_int[4], wen_int[3], wen_int[2], wen_int[1], wen_int[0]});
      if (gwen_int !== 1'b1) begin
        row_mask =  ( {1'b0, writeEnable[127], 1'b0, writeEnable[126], 1'b0, writeEnable[125],
          1'b0, writeEnable[124], 1'b0, writeEnable[123], 1'b0, writeEnable[122], 1'b0, writeEnable[121],
          1'b0, writeEnable[120], 1'b0, writeEnable[119], 1'b0, writeEnable[118], 1'b0, writeEnable[117],
          1'b0, writeEnable[116], 1'b0, writeEnable[115], 1'b0, writeEnable[114], 1'b0, writeEnable[113],
          1'b0, writeEnable[112], 1'b0, writeEnable[111], 1'b0, writeEnable[110], 1'b0, writeEnable[109],
          1'b0, writeEnable[108], 1'b0, writeEnable[107], 1'b0, writeEnable[106], 1'b0, writeEnable[105],
          1'b0, writeEnable[104], 1'b0, writeEnable[103], 1'b0, writeEnable[102], 1'b0, writeEnable[101],
          1'b0, writeEnable[100], 1'b0, writeEnable[99], 1'b0, writeEnable[98], 1'b0, writeEnable[97],
          1'b0, writeEnable[96], 1'b0, writeEnable[95], 1'b0, writeEnable[94], 1'b0, writeEnable[93],
          1'b0, writeEnable[92], 1'b0, writeEnable[91], 1'b0, writeEnable[90], 1'b0, writeEnable[89],
          1'b0, writeEnable[88], 1'b0, writeEnable[87], 1'b0, writeEnable[86], 1'b0, writeEnable[85],
          1'b0, writeEnable[84], 1'b0, writeEnable[83], 1'b0, writeEnable[82], 1'b0, writeEnable[81],
          1'b0, writeEnable[80], 1'b0, writeEnable[79], 1'b0, writeEnable[78], 1'b0, writeEnable[77],
          1'b0, writeEnable[76], 1'b0, writeEnable[75], 1'b0, writeEnable[74], 1'b0, writeEnable[73],
          1'b0, writeEnable[72], 1'b0, writeEnable[71], 1'b0, writeEnable[70], 1'b0, writeEnable[69],
          1'b0, writeEnable[68], 1'b0, writeEnable[67], 1'b0, writeEnable[66], 1'b0, writeEnable[65],
          1'b0, writeEnable[64], 1'b0, writeEnable[63], 1'b0, writeEnable[62], 1'b0, writeEnable[61],
          1'b0, writeEnable[60], 1'b0, writeEnable[59], 1'b0, writeEnable[58], 1'b0, writeEnable[57],
          1'b0, writeEnable[56], 1'b0, writeEnable[55], 1'b0, writeEnable[54], 1'b0, writeEnable[53],
          1'b0, writeEnable[52], 1'b0, writeEnable[51], 1'b0, writeEnable[50], 1'b0, writeEnable[49],
          1'b0, writeEnable[48], 1'b0, writeEnable[47], 1'b0, writeEnable[46], 1'b0, writeEnable[45],
          1'b0, writeEnable[44], 1'b0, writeEnable[43], 1'b0, writeEnable[42], 1'b0, writeEnable[41],
          1'b0, writeEnable[40], 1'b0, writeEnable[39], 1'b0, writeEnable[38], 1'b0, writeEnable[37],
          1'b0, writeEnable[36], 1'b0, writeEnable[35], 1'b0, writeEnable[34], 1'b0, writeEnable[33],
          1'b0, writeEnable[32], 1'b0, writeEnable[31], 1'b0, writeEnable[30], 1'b0, writeEnable[29],
          1'b0, writeEnable[28], 1'b0, writeEnable[27], 1'b0, writeEnable[26], 1'b0, writeEnable[25],
          1'b0, writeEnable[24], 1'b0, writeEnable[23], 1'b0, writeEnable[22], 1'b0, writeEnable[21],
          1'b0, writeEnable[20], 1'b0, writeEnable[19], 1'b0, writeEnable[18], 1'b0, writeEnable[17],
          1'b0, writeEnable[16], 1'b0, writeEnable[15], 1'b0, writeEnable[14], 1'b0, writeEnable[13],
          1'b0, writeEnable[12], 1'b0, writeEnable[11], 1'b0, writeEnable[10], 1'b0, writeEnable[9],
          1'b0, writeEnable[8], 1'b0, writeEnable[7], 1'b0, writeEnable[6], 1'b0, writeEnable[5],
          1'b0, writeEnable[4], 1'b0, writeEnable[3], 1'b0, writeEnable[2], 1'b0, writeEnable[1],
          1'b0, writeEnable[0]} << mux_address);
        new_data =  ( {1'b0, d_int[127], 1'b0, d_int[126], 1'b0, d_int[125], 1'b0, d_int[124],
          1'b0, d_int[123], 1'b0, d_int[122], 1'b0, d_int[121], 1'b0, d_int[120], 1'b0, d_int[119],
          1'b0, d_int[118], 1'b0, d_int[117], 1'b0, d_int[116], 1'b0, d_int[115], 1'b0, d_int[114],
          1'b0, d_int[113], 1'b0, d_int[112], 1'b0, d_int[111], 1'b0, d_int[110], 1'b0, d_int[109],
          1'b0, d_int[108], 1'b0, d_int[107], 1'b0, d_int[106], 1'b0, d_int[105], 1'b0, d_int[104],
          1'b0, d_int[103], 1'b0, d_int[102], 1'b0, d_int[101], 1'b0, d_int[100], 1'b0, d_int[99],
          1'b0, d_int[98], 1'b0, d_int[97], 1'b0, d_int[96], 1'b0, d_int[95], 1'b0, d_int[94],
          1'b0, d_int[93], 1'b0, d_int[92], 1'b0, d_int[91], 1'b0, d_int[90], 1'b0, d_int[89],
          1'b0, d_int[88], 1'b0, d_int[87], 1'b0, d_int[86], 1'b0, d_int[85], 1'b0, d_int[84],
          1'b0, d_int[83], 1'b0, d_int[82], 1'b0, d_int[81], 1'b0, d_int[80], 1'b0, d_int[79],
          1'b0, d_int[78], 1'b0, d_int[77], 1'b0, d_int[76], 1'b0, d_int[75], 1'b0, d_int[74],
          1'b0, d_int[73], 1'b0, d_int[72], 1'b0, d_int[71], 1'b0, d_int[70], 1'b0, d_int[69],
          1'b0, d_int[68], 1'b0, d_int[67], 1'b0, d_int[66], 1'b0, d_int[65], 1'b0, d_int[64],
          1'b0, d_int[63], 1'b0, d_int[62], 1'b0, d_int[61], 1'b0, d_int[60], 1'b0, d_int[59],
          1'b0, d_int[58], 1'b0, d_int[57], 1'b0, d_int[56], 1'b0, d_int[55], 1'b0, d_int[54],
          1'b0, d_int[53], 1'b0, d_int[52], 1'b0, d_int[51], 1'b0, d_int[50], 1'b0, d_int[49],
          1'b0, d_int[48], 1'b0, d_int[47], 1'b0, d_int[46], 1'b0, d_int[45], 1'b0, d_int[44],
          1'b0, d_int[43], 1'b0, d_int[42], 1'b0, d_int[41], 1'b0, d_int[40], 1'b0, d_int[39],
          1'b0, d_int[38], 1'b0, d_int[37], 1'b0, d_int[36], 1'b0, d_int[35], 1'b0, d_int[34],
          1'b0, d_int[33], 1'b0, d_int[32], 1'b0, d_int[31], 1'b0, d_int[30], 1'b0, d_int[29],
          1'b0, d_int[28], 1'b0, d_int[27], 1'b0, d_int[26], 1'b0, d_int[25], 1'b0, d_int[24],
          1'b0, d_int[23], 1'b0, d_int[22], 1'b0, d_int[21], 1'b0, d_int[20], 1'b0, d_int[19],
          1'b0, d_int[18], 1'b0, d_int[17], 1'b0, d_int[16], 1'b0, d_int[15], 1'b0, d_int[14],
          1'b0, d_int[13], 1'b0, d_int[12], 1'b0, d_int[11], 1'b0, d_int[10], 1'b0, d_int[9],
          1'b0, d_int[8], 1'b0, d_int[7], 1'b0, d_int[6], 1'b0, d_int[5], 1'b0, d_int[4],
          1'b0, d_int[3], 1'b0, d_int[2], 1'b0, d_int[1], 1'b0, d_int[0]} << mux_address);
        row = (row & ~row_mask) | (row_mask & (~row_mask | new_data));
        mem[row_address] = row;
      end else begin
        data_out = (row >> (mux_address));
        readLatch0 = {data_out[254], data_out[252], data_out[250], data_out[248], data_out[246],
          data_out[244], data_out[242], data_out[240], data_out[238], data_out[236],
          data_out[234], data_out[232], data_out[230], data_out[228], data_out[226],
          data_out[224], data_out[222], data_out[220], data_out[218], data_out[216],
          data_out[214], data_out[212], data_out[210], data_out[208], data_out[206],
          data_out[204], data_out[202], data_out[200], data_out[198], data_out[196],
          data_out[194], data_out[192], data_out[190], data_out[188], data_out[186],
          data_out[184], data_out[182], data_out[180], data_out[178], data_out[176],
          data_out[174], data_out[172], data_out[170], data_out[168], data_out[166],
          data_out[164], data_out[162], data_out[160], data_out[158], data_out[156],
          data_out[154], data_out[152], data_out[150], data_out[148], data_out[146],
          data_out[144], data_out[142], data_out[140], data_out[138], data_out[136],
          data_out[134], data_out[132], data_out[130], data_out[128], data_out[126],
          data_out[124], data_out[122], data_out[120], data_out[118], data_out[116],
          data_out[114], data_out[112], data_out[110], data_out[108], data_out[106],
          data_out[104], data_out[102], data_out[100], data_out[98], data_out[96],
          data_out[94], data_out[92], data_out[90], data_out[88], data_out[86], data_out[84],
          data_out[82], data_out[80], data_out[78], data_out[76], data_out[74], data_out[72],
          data_out[70], data_out[68], data_out[66], data_out[64], data_out[62], data_out[60],
          data_out[58], data_out[56], data_out[54], data_out[52], data_out[50], data_out[48],
          data_out[46], data_out[44], data_out[42], data_out[40], data_out[38], data_out[36],
          data_out[34], data_out[32], data_out[30], data_out[28], data_out[26], data_out[24],
          data_out[22], data_out[20], data_out[18], data_out[16], data_out[14], data_out[12],
          data_out[10], data_out[8], data_out[6], data_out[4], data_out[2], data_out[0]};
        shifted_readLatch0 = readLatch0;
        q_int = {shifted_readLatch0[127], shifted_readLatch0[126], shifted_readLatch0[125],
          shifted_readLatch0[124], shifted_readLatch0[123], shifted_readLatch0[122],
          shifted_readLatch0[121], shifted_readLatch0[120], shifted_readLatch0[119],
          shifted_readLatch0[118], shifted_readLatch0[117], shifted_readLatch0[116],
          shifted_readLatch0[115], shifted_readLatch0[114], shifted_readLatch0[113],
          shifted_readLatch0[112], shifted_readLatch0[111], shifted_readLatch0[110],
          shifted_readLatch0[109], shifted_readLatch0[108], shifted_readLatch0[107],
          shifted_readLatch0[106], shifted_readLatch0[105], shifted_readLatch0[104],
          shifted_readLatch0[103], shifted_readLatch0[102], shifted_readLatch0[101],
          shifted_readLatch0[100], shifted_readLatch0[99], shifted_readLatch0[98],
          shifted_readLatch0[97], shifted_readLatch0[96], shifted_readLatch0[95], shifted_readLatch0[94],
          shifted_readLatch0[93], shifted_readLatch0[92], shifted_readLatch0[91], shifted_readLatch0[90],
          shifted_readLatch0[89], shifted_readLatch0[88], shifted_readLatch0[87], shifted_readLatch0[86],
          shifted_readLatch0[85], shifted_readLatch0[84], shifted_readLatch0[83], shifted_readLatch0[82],
          shifted_readLatch0[81], shifted_readLatch0[80], shifted_readLatch0[79], shifted_readLatch0[78],
          shifted_readLatch0[77], shifted_readLatch0[76], shifted_readLatch0[75], shifted_readLatch0[74],
          shifted_readLatch0[73], shifted_readLatch0[72], shifted_readLatch0[71], shifted_readLatch0[70],
          shifted_readLatch0[69], shifted_readLatch0[68], shifted_readLatch0[67], shifted_readLatch0[66],
          shifted_readLatch0[65], shifted_readLatch0[64], shifted_readLatch0[63], shifted_readLatch0[62],
          shifted_readLatch0[61], shifted_readLatch0[60], shifted_readLatch0[59], shifted_readLatch0[58],
          shifted_readLatch0[57], shifted_readLatch0[56], shifted_readLatch0[55], shifted_readLatch0[54],
          shifted_readLatch0[53], shifted_readLatch0[52], shifted_readLatch0[51], shifted_readLatch0[50],
          shifted_readLatch0[49], shifted_readLatch0[48], shifted_readLatch0[47], shifted_readLatch0[46],
          shifted_readLatch0[45], shifted_readLatch0[44], shifted_readLatch0[43], shifted_readLatch0[42],
          shifted_readLatch0[41], shifted_readLatch0[40], shifted_readLatch0[39], shifted_readLatch0[38],
          shifted_readLatch0[37], shifted_readLatch0[36], shifted_readLatch0[35], shifted_readLatch0[34],
          shifted_readLatch0[33], shifted_readLatch0[32], shifted_readLatch0[31], shifted_readLatch0[30],
          shifted_readLatch0[29], shifted_readLatch0[28], shifted_readLatch0[27], shifted_readLatch0[26],
          shifted_readLatch0[25], shifted_readLatch0[24], shifted_readLatch0[23], shifted_readLatch0[22],
          shifted_readLatch0[21], shifted_readLatch0[20], shifted_readLatch0[19], shifted_readLatch0[18],
          shifted_readLatch0[17], shifted_readLatch0[16], shifted_readLatch0[15], shifted_readLatch0[14],
          shifted_readLatch0[13], shifted_readLatch0[12], shifted_readLatch0[11], shifted_readLatch0[10],
          shifted_readLatch0[9], shifted_readLatch0[8], shifted_readLatch0[7], shifted_readLatch0[6],
          shifted_readLatch0[5], shifted_readLatch0[4], shifted_readLatch0[3], shifted_readLatch0[2],
          shifted_readLatch0[1], shifted_readLatch0[0]};
      end
      if( isBitX(gwen_int) ) begin
        q_int = {128{1'bx}};
      end
    end
  end
  endtask
  always @ (cen_ or clk_) begin
  	if(clk_ == 1'b0) begin
  		cen_p2 = cen_;
  	end
  end

`ifdef POWER_PINS
  always @ (posedge VDDCE or negedge VDDCE) begin
      if (VDDCE != 1'b1) begin
       if (VDDPE == 1'b1) begin
        $display("VDDCE should be powered down after VDDPE, Illegal power down sequencing in %m at %0t", $time);
       end
        $display("In PowerDown Mode in %m at %0t", $time);
        failedWrite(0);
      end
      if (VDDCE == 1'b1) begin
       if (VDDPE == 1'b1) begin
        $display("VDDPE should be powered up after VDDCE in %m at %0t", $time);
        $display("Illegal power up sequencing in %m at %0t", $time);
       end
        failedWrite(0);
      end
  end
`endif
`ifdef POWER_PINS
  always @ (ret1n_ or VDDPE or VDDCE) begin
`else     
  always @ ret1n_ begin
`endif
`ifdef POWER_PINS
    if (ret1n_ == 1'b1 && ret1n_int == 1'b1 && VDDCE == 1'b1 && VDDPE == 1'b1 && pre_charge_st == 1'b1 && (cen_ === 1'bx || clk_ === 1'bx)) begin
      failedWrite(0);
        q_int = {128{1'bx}};
    end
`else     
`endif
`ifdef POWER_PINS
`else     
      pre_charge_st = 0;
`endif
    if (ret1n_ === 1'bx || ret1n_ === 1'bz) begin
      failedWrite(0);
        q_int = {128{1'bx}};
    end else if (ret1n_ === 1'b0 && ret1n_int === 1'b1 && cen_p2 === 1'b0 ) begin
      failedWrite(0);
        q_int = {128{1'bx}};
    end else if (ret1n_ === 1'b1 && ret1n_int === 1'b0 && cen_p2 === 1'b0 ) begin
      failedWrite(0);
        q_int = {128{1'bx}};
    end
`ifdef POWER_PINS
    if (ret1n_ == 1'b0 && VDDCE == 1'b1 && VDDPE == 1'b1) begin
      pre_charge_st = 1;
    end else if (ret1n_ == 1'b0 && VDDPE == 1'b0) begin
      pre_charge_st = 0;
      if (VDDCE != 1'b1) begin
        failedWrite(0);
      end
`else     
    if (ret1n_ == 1'b0) begin
`endif
      q_int = {128{1'bx}};
      cen_int = 1'bx;
      wen_int = {128{1'bx}};
      a_int = {7{1'bx}};
      d_int = {128{1'bx}};
      ema_int = {3{1'bx}};
      emaw_int = {2{1'bx}};
      emas_int = 1'bx;
      gwen_int = 1'bx;
      ret1n_int = 1'bx;
`ifdef POWER_PINS
    end else if (ret1n_ == 1'b1 && VDDCE == 1'b1 && VDDPE == 1'b1 &&  pre_charge_st == 1'b1) begin
      pre_charge_st = 0;
    end else begin
      pre_charge_st = 0;
`else     
    end else begin
`endif
        q_int = {128{1'bx}};
      cen_int = 1'bx;
      wen_int = {128{1'bx}};
      a_int = {7{1'bx}};
      d_int = {128{1'bx}};
      ema_int = {3{1'bx}};
      emaw_int = {2{1'bx}};
      emas_int = 1'bx;
      gwen_int = 1'bx;
      ret1n_int = 1'bx;
    end
    ret1n_int = ret1n_;
  end


  always @ clk_ begin
// If POWER_PINS is defined at Simulator Command Line, it selects the module definition with Power Ports
`ifdef POWER_PINS
    if (VDDCE === 1'bx || VDDCE === 1'bz)
      $display("Warning: Unknown value for VDDCE %b in %m at %0t", VDDCE, $time);
    if (VDDPE === 1'bx || VDDPE === 1'bz)
      $display("Warning: Unknown value for VDDPE %b in %m at %0t", VDDPE, $time);
    if (VSSE === 1'bx || VSSE === 1'bz)
      $display("Warning: Unknown value for VSSE %b in %m at %0t", VSSE, $time);
`endif
`ifdef POWER_PINS
  if (ret1n_ == 1'b0) begin
`else     
  if (ret1n_ == 1'b0) begin
`endif
      // no cycle in retention mode
  end else begin
    if ((clk_ === 1'bx || clk_ === 1'bz) && ret1n_ !== 1'b0) begin
      failedWrite(0);
        q_int = {128{1'bx}};
    end else if (clk_ === 1'b1 && LAST_clk === 1'b0) begin
      cen_int = cen_;
      ema_int = ema_;
      emaw_int = emaw_;
      emas_int = emas_;
      ret1n_int = ret1n_;
      if (cen_int != 1'b1) begin
        wen_int = wen_;
        a_int = a_;
        d_int = d_;
        gwen_int = gwen_;
      end
      clk0_int = 1'b0;
      cen_int = cen_;
      ema_int = ema_;
      emaw_int = emaw_;
      emas_int = emas_;
      ret1n_int = ret1n_;
      if (cen_int != 1'b1) begin
        wen_int = wen_;
        a_int = a_;
        d_int = d_;
        gwen_int = gwen_;
      end
      clk0_int = 1'b0;
    readWrite;
    end else if (clk_ === 1'b0 && LAST_clk === 1'b1) begin
    end
  end
    LAST_clk = clk_;
  end
reg clk_s;

always @ (clk_)
    clk_s <= clk_;

// If POWER_PINS is defined at Simulator Command Line, it selects the module definition with Power Ports
`ifdef POWER_PINS
	always @ (VDDCE or VDDPE or VSSE or clk_s) begin
		if (VDDCE !== 1'b1) begin
			$display("Warning: Unknown value for VDDCE %b in %m at %0t", VDDCE, $time);
        q_int = {128{1'bx}};
			failedWrite(0);
			bad_VDDCE = 1'b1;
		end else begin
			bad_VDDCE = 1'b0;
		end
		if (VDDPE !== 1'b1) begin
			$display("Warning: Unknown value for VDDPE %b in %m at %0t", VDDPE, $time);
        q_int = {128{1'bx}};
		if (ret1n_ !== 1'b0)
			failedWrite(0);
			bad_VDDPE = 1'b1;
		end else begin
			bad_VDDPE = 1'b0;
		end
		if (VSSE !== 1'b0) begin
			$display("Warning: Unknown value for VSSE %b in %m at %0t", VSSE, $time);
        q_int = {128{1'bx}};
			failedWrite(0);
			bad_VSSE = 1'b1;
		end else begin
			bad_VSSE = 1'b0;
		end
		bad_power = bad_VDDCE | bad_VDDPE | bad_VSSE ;
	end
`endif

endmodule
`endcelldefine
`else
`celldefine
// If POWER_PINS is defined at Simulator Command Line, it selects the module definition with Power Ports
`ifdef POWER_PINS
module rf128x128 (VDDCE, VDDPE, VSSE, q, clk, cen, wen, a, d, ema, emaw, emas, gwen,
    ret1n);
`else
module rf128x128 (q, clk, cen, wen, a, d, ema, emaw, emas, gwen, ret1n);
`endif

  parameter ASSERT_PREFIX = "";
  parameter BITS = 128;
  parameter WORDS = 128;
  parameter MUX = 2;
  parameter MEM_WIDTH = 256; // redun block size 2, 128 on left, 128 on right
  parameter MEM_HEIGHT = 64;
  parameter WP_SIZE = 1 ;
  parameter UPM_WIDTH = 3;
  parameter UPMW_WIDTH = 2;
  parameter UPMS_WIDTH = 1;

`ifdef ARM_DISABLE_EMA_CHECK
parameter ARM_LOCAL_DISABLE_EMA_CHECK = 1;
`else
parameter ARM_LOCAL_DISABLE_EMA_CHECK = 0;
`endif

  parameter ARM_REF_EMA_VALUE = 2**UPM_WIDTH-1;
  parameter ARM_REF_EMAW_VALUE = 2**UPMW_WIDTH-1;
  parameter ARM_REF_EMAS_VALUE = 2**UPMS_WIDTH-1;

  output [127:0] q;
  input  clk;
  input  cen;
  input [127:0] wen;
  input [6:0] a;
  input [127:0] d;
  input [2:0] ema;
  input [1:0] emaw;
  input  emas;
  input  gwen;
  input  ret1n;
`ifdef POWER_PINS
  inout VDDCE;
  inout VDDPE;
  inout VSSE;
`endif
`ifdef POWER_PINS
  reg bad_VDDCE;
  reg bad_VDDPE;
  reg bad_VSSE;
  reg bad_power;
`endif
 wire corrupt_power;
`ifdef POWER_PINS
  assign corrupt_power = bad_power;
`else
  assign corrupt_power = 1'b0;
`endif

  reg pre_charge_st;
  integer row_address;
  integer mux_address;
  initial row_address = 0;
  initial mux_address = 0;
  reg [255:0] mem [0:63];
  reg [255:0] row, row_t;
  reg LAST_clk;
  reg [255:0] row_mask;
  reg [255:0] new_data;
  reg [255:0] data_out;
  reg [127:0] readLatch0;
  reg [127:0] shifted_readLatch0;
  reg [127:0] q_int;
  reg [127:0] writeEnable;

  reg NOT_cen, NOT_wen127, NOT_wen126, NOT_wen125, NOT_wen124, NOT_wen123, NOT_wen122;
  reg NOT_wen121, NOT_wen120, NOT_wen119, NOT_wen118, NOT_wen117, NOT_wen116, NOT_wen115;
  reg NOT_wen114, NOT_wen113, NOT_wen112, NOT_wen111, NOT_wen110, NOT_wen109, NOT_wen108;
  reg NOT_wen107, NOT_wen106, NOT_wen105, NOT_wen104, NOT_wen103, NOT_wen102, NOT_wen101;
  reg NOT_wen100, NOT_wen99, NOT_wen98, NOT_wen97, NOT_wen96, NOT_wen95, NOT_wen94;
  reg NOT_wen93, NOT_wen92, NOT_wen91, NOT_wen90, NOT_wen89, NOT_wen88, NOT_wen87;
  reg NOT_wen86, NOT_wen85, NOT_wen84, NOT_wen83, NOT_wen82, NOT_wen81, NOT_wen80;
  reg NOT_wen79, NOT_wen78, NOT_wen77, NOT_wen76, NOT_wen75, NOT_wen74, NOT_wen73;
  reg NOT_wen72, NOT_wen71, NOT_wen70, NOT_wen69, NOT_wen68, NOT_wen67, NOT_wen66;
  reg NOT_wen65, NOT_wen64, NOT_wen63, NOT_wen62, NOT_wen61, NOT_wen60, NOT_wen59;
  reg NOT_wen58, NOT_wen57, NOT_wen56, NOT_wen55, NOT_wen54, NOT_wen53, NOT_wen52;
  reg NOT_wen51, NOT_wen50, NOT_wen49, NOT_wen48, NOT_wen47, NOT_wen46, NOT_wen45;
  reg NOT_wen44, NOT_wen43, NOT_wen42, NOT_wen41, NOT_wen40, NOT_wen39, NOT_wen38;
  reg NOT_wen37, NOT_wen36, NOT_wen35, NOT_wen34, NOT_wen33, NOT_wen32, NOT_wen31;
  reg NOT_wen30, NOT_wen29, NOT_wen28, NOT_wen27, NOT_wen26, NOT_wen25, NOT_wen24;
  reg NOT_wen23, NOT_wen22, NOT_wen21, NOT_wen20, NOT_wen19, NOT_wen18, NOT_wen17;
  reg NOT_wen16, NOT_wen15, NOT_wen14, NOT_wen13, NOT_wen12, NOT_wen11, NOT_wen10;
  reg NOT_wen9, NOT_wen8, NOT_wen7, NOT_wen6, NOT_wen5, NOT_wen4, NOT_wen3, NOT_wen2;
  reg NOT_wen1, NOT_wen0, NOT_a6, NOT_a5, NOT_a4, NOT_a3, NOT_a2, NOT_a1, NOT_a0, NOT_d127;
  reg NOT_d126, NOT_d125, NOT_d124, NOT_d123, NOT_d122, NOT_d121, NOT_d120, NOT_d119;
  reg NOT_d118, NOT_d117, NOT_d116, NOT_d115, NOT_d114, NOT_d113, NOT_d112, NOT_d111;
  reg NOT_d110, NOT_d109, NOT_d108, NOT_d107, NOT_d106, NOT_d105, NOT_d104, NOT_d103;
  reg NOT_d102, NOT_d101, NOT_d100, NOT_d99, NOT_d98, NOT_d97, NOT_d96, NOT_d95, NOT_d94;
  reg NOT_d93, NOT_d92, NOT_d91, NOT_d90, NOT_d89, NOT_d88, NOT_d87, NOT_d86, NOT_d85;
  reg NOT_d84, NOT_d83, NOT_d82, NOT_d81, NOT_d80, NOT_d79, NOT_d78, NOT_d77, NOT_d76;
  reg NOT_d75, NOT_d74, NOT_d73, NOT_d72, NOT_d71, NOT_d70, NOT_d69, NOT_d68, NOT_d67;
  reg NOT_d66, NOT_d65, NOT_d64, NOT_d63, NOT_d62, NOT_d61, NOT_d60, NOT_d59, NOT_d58;
  reg NOT_d57, NOT_d56, NOT_d55, NOT_d54, NOT_d53, NOT_d52, NOT_d51, NOT_d50, NOT_d49;
  reg NOT_d48, NOT_d47, NOT_d46, NOT_d45, NOT_d44, NOT_d43, NOT_d42, NOT_d41, NOT_d40;
  reg NOT_d39, NOT_d38, NOT_d37, NOT_d36, NOT_d35, NOT_d34, NOT_d33, NOT_d32, NOT_d31;
  reg NOT_d30, NOT_d29, NOT_d28, NOT_d27, NOT_d26, NOT_d25, NOT_d24, NOT_d23, NOT_d22;
  reg NOT_d21, NOT_d20, NOT_d19, NOT_d18, NOT_d17, NOT_d16, NOT_d15, NOT_d14, NOT_d13;
  reg NOT_d12, NOT_d11, NOT_d10, NOT_d9, NOT_d8, NOT_d7, NOT_d6, NOT_d5, NOT_d4, NOT_d3;
  reg NOT_d2, NOT_d1, NOT_d0, NOT_ema2, NOT_ema1, NOT_ema0, NOT_emaw1, NOT_emaw0, NOT_emas;
  reg NOT_gwen, NOT_ret1n;
  reg NOT_clk_PER, NOT_clk_MINH, NOT_clk_MINL;
  reg clk0_int;

  wire [127:0] q_;
 wire  clk_;
  wire  cen_;
  reg  cen_int;
  reg  cen_p2;
  wire [127:0] wen_;
  reg [127:0] wen_int;
  wire [6:0] a_;
  reg [6:0] a_int;
  wire [127:0] d_;
  reg [127:0] d_int;
  wire [2:0] ema_;
  reg [2:0] ema_int;
  wire [1:0] emaw_;
  reg [1:0] emaw_int;
  wire  emas_;
  reg  emas_int;
  wire  gwen_;
  reg  gwen_int;
  wire  ret1n_;
  reg  ret1n_int;

  buf B0(q[0], q_[0]);
  buf B1(q[1], q_[1]);
  buf B2(q[2], q_[2]);
  buf B3(q[3], q_[3]);
  buf B4(q[4], q_[4]);
  buf B5(q[5], q_[5]);
  buf B6(q[6], q_[6]);
  buf B7(q[7], q_[7]);
  buf B8(q[8], q_[8]);
  buf B9(q[9], q_[9]);
  buf B10(q[10], q_[10]);
  buf B11(q[11], q_[11]);
  buf B12(q[12], q_[12]);
  buf B13(q[13], q_[13]);
  buf B14(q[14], q_[14]);
  buf B15(q[15], q_[15]);
  buf B16(q[16], q_[16]);
  buf B17(q[17], q_[17]);
  buf B18(q[18], q_[18]);
  buf B19(q[19], q_[19]);
  buf B20(q[20], q_[20]);
  buf B21(q[21], q_[21]);
  buf B22(q[22], q_[22]);
  buf B23(q[23], q_[23]);
  buf B24(q[24], q_[24]);
  buf B25(q[25], q_[25]);
  buf B26(q[26], q_[26]);
  buf B27(q[27], q_[27]);
  buf B28(q[28], q_[28]);
  buf B29(q[29], q_[29]);
  buf B30(q[30], q_[30]);
  buf B31(q[31], q_[31]);
  buf B32(q[32], q_[32]);
  buf B33(q[33], q_[33]);
  buf B34(q[34], q_[34]);
  buf B35(q[35], q_[35]);
  buf B36(q[36], q_[36]);
  buf B37(q[37], q_[37]);
  buf B38(q[38], q_[38]);
  buf B39(q[39], q_[39]);
  buf B40(q[40], q_[40]);
  buf B41(q[41], q_[41]);
  buf B42(q[42], q_[42]);
  buf B43(q[43], q_[43]);
  buf B44(q[44], q_[44]);
  buf B45(q[45], q_[45]);
  buf B46(q[46], q_[46]);
  buf B47(q[47], q_[47]);
  buf B48(q[48], q_[48]);
  buf B49(q[49], q_[49]);
  buf B50(q[50], q_[50]);
  buf B51(q[51], q_[51]);
  buf B52(q[52], q_[52]);
  buf B53(q[53], q_[53]);
  buf B54(q[54], q_[54]);
  buf B55(q[55], q_[55]);
  buf B56(q[56], q_[56]);
  buf B57(q[57], q_[57]);
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
  buf B400(ret1n_, ret1n);

   `ifdef ARM_FAULT_MODELING
     rf128x128_error_injection u1(.CLK(clk_), .Q_out(q_), .A(a_int), .CEN(cen_int), .GWEN(gwen_int), .WEN(wen_int), .Q_in(q_int));
  `else
  assign q_ = (ret1n_ | pre_charge_st) & ~corrupt_power ? ((q_int)) : {128{1'bx}};
  `endif

// If INITIALIZE_MEMORY is defined at Simulator Command Line, it Initializes the Memory with all ZEROS.
`ifdef INITIALIZE_MEMORY
  integer i;
  initial begin
    #0;
    for (i = 0; i < MEM_HEIGHT; i = i + 1)
      mem[i] = {MEM_WIDTH{1'b0}};
  end
`endif
  always @ (posedge clk_  ) begin
      if(ema_ !== ARM_REF_EMA_VALUE && (ARM_LOCAL_DISABLE_EMA_CHECK == 0) &&  (((cen_int === 1'b0 &&  clk_ === 1'b1) ) && ret1n_ === 1'b1  )) 
      $display("Warning: Set Value for ema is %d and is not equal to %d in %m at %0t. Please refer README for correct value of ema", ema_, ARM_REF_EMA_VALUE, $time);
  end
  always @ (posedge clk_ ) begin
      if(emaw_ !== ARM_REF_EMAW_VALUE && (ARM_LOCAL_DISABLE_EMA_CHECK == 0) &&  (((cen_int === 1'b0 &&  clk_ === 1'b1) ) && ret1n_ === 1'b1  )) 
      $display("Warning: Set Value for emaw is %d and is not equal to %d in %m at %0t. Please refer README for correct value of emaw", emaw_, ARM_REF_EMAW_VALUE, $time);
  end
  always @ (posedge clk_  ) begin
      if(emas_ !== ARM_REF_EMAS_VALUE  && (ARM_LOCAL_DISABLE_EMA_CHECK == 0) &&  (((cen_int === 1'b0 &&  clk_ === 1'b1) ) && ret1n_ === 1'b1  )) 
      $display("Warning: Set Value for emas is %d and is not equal to %d in %m at %0t. Please refer README for correct value of emas", emas_, ARM_REF_EMAS_VALUE, $time);
  end

  task failedWrite;
  input port_f;
  integer i;
  begin
    for (i = 0; i < MEM_HEIGHT; i = i + 1)
      mem[i] = {MEM_WIDTH{1'bx}};
  end
  endtask

  function isBitX;
    input bitval;
    begin
      isBitX = ( bitval===1'bx || bitval===1'bz ) ? 1'b1 : 1'b0;
    end
  endfunction


task loadmem;
	input [1000*8-1:0] filename;
	reg [BITS-1:0] memld [0:WORDS-1];
	integer i;
	reg [BITS-1:0] wordtemp;
	reg [6:0] Atemp;
  begin
	$readmemb(filename, memld);
`ifdef ARM_BACKDOOR_NOCEN
`else
	if (cen_ === 1'b1) begin
`endif
	  for (i=0;i<WORDS;i=i+1) begin
	  wordtemp = memld[i];
	  Atemp = i;
	  mux_address = (Atemp & 1'b1);
      row_address = (Atemp >> 1);
      row = mem[row_address];
        writeEnable = {128{1'b1}};
        row_mask =  ( {1'b0, writeEnable[127], 1'b0, writeEnable[126], 1'b0, writeEnable[125],
          1'b0, writeEnable[124], 1'b0, writeEnable[123], 1'b0, writeEnable[122], 1'b0, writeEnable[121],
          1'b0, writeEnable[120], 1'b0, writeEnable[119], 1'b0, writeEnable[118], 1'b0, writeEnable[117],
          1'b0, writeEnable[116], 1'b0, writeEnable[115], 1'b0, writeEnable[114], 1'b0, writeEnable[113],
          1'b0, writeEnable[112], 1'b0, writeEnable[111], 1'b0, writeEnable[110], 1'b0, writeEnable[109],
          1'b0, writeEnable[108], 1'b0, writeEnable[107], 1'b0, writeEnable[106], 1'b0, writeEnable[105],
          1'b0, writeEnable[104], 1'b0, writeEnable[103], 1'b0, writeEnable[102], 1'b0, writeEnable[101],
          1'b0, writeEnable[100], 1'b0, writeEnable[99], 1'b0, writeEnable[98], 1'b0, writeEnable[97],
          1'b0, writeEnable[96], 1'b0, writeEnable[95], 1'b0, writeEnable[94], 1'b0, writeEnable[93],
          1'b0, writeEnable[92], 1'b0, writeEnable[91], 1'b0, writeEnable[90], 1'b0, writeEnable[89],
          1'b0, writeEnable[88], 1'b0, writeEnable[87], 1'b0, writeEnable[86], 1'b0, writeEnable[85],
          1'b0, writeEnable[84], 1'b0, writeEnable[83], 1'b0, writeEnable[82], 1'b0, writeEnable[81],
          1'b0, writeEnable[80], 1'b0, writeEnable[79], 1'b0, writeEnable[78], 1'b0, writeEnable[77],
          1'b0, writeEnable[76], 1'b0, writeEnable[75], 1'b0, writeEnable[74], 1'b0, writeEnable[73],
          1'b0, writeEnable[72], 1'b0, writeEnable[71], 1'b0, writeEnable[70], 1'b0, writeEnable[69],
          1'b0, writeEnable[68], 1'b0, writeEnable[67], 1'b0, writeEnable[66], 1'b0, writeEnable[65],
          1'b0, writeEnable[64], 1'b0, writeEnable[63], 1'b0, writeEnable[62], 1'b0, writeEnable[61],
          1'b0, writeEnable[60], 1'b0, writeEnable[59], 1'b0, writeEnable[58], 1'b0, writeEnable[57],
          1'b0, writeEnable[56], 1'b0, writeEnable[55], 1'b0, writeEnable[54], 1'b0, writeEnable[53],
          1'b0, writeEnable[52], 1'b0, writeEnable[51], 1'b0, writeEnable[50], 1'b0, writeEnable[49],
          1'b0, writeEnable[48], 1'b0, writeEnable[47], 1'b0, writeEnable[46], 1'b0, writeEnable[45],
          1'b0, writeEnable[44], 1'b0, writeEnable[43], 1'b0, writeEnable[42], 1'b0, writeEnable[41],
          1'b0, writeEnable[40], 1'b0, writeEnable[39], 1'b0, writeEnable[38], 1'b0, writeEnable[37],
          1'b0, writeEnable[36], 1'b0, writeEnable[35], 1'b0, writeEnable[34], 1'b0, writeEnable[33],
          1'b0, writeEnable[32], 1'b0, writeEnable[31], 1'b0, writeEnable[30], 1'b0, writeEnable[29],
          1'b0, writeEnable[28], 1'b0, writeEnable[27], 1'b0, writeEnable[26], 1'b0, writeEnable[25],
          1'b0, writeEnable[24], 1'b0, writeEnable[23], 1'b0, writeEnable[22], 1'b0, writeEnable[21],
          1'b0, writeEnable[20], 1'b0, writeEnable[19], 1'b0, writeEnable[18], 1'b0, writeEnable[17],
          1'b0, writeEnable[16], 1'b0, writeEnable[15], 1'b0, writeEnable[14], 1'b0, writeEnable[13],
          1'b0, writeEnable[12], 1'b0, writeEnable[11], 1'b0, writeEnable[10], 1'b0, writeEnable[9],
          1'b0, writeEnable[8], 1'b0, writeEnable[7], 1'b0, writeEnable[6], 1'b0, writeEnable[5],
          1'b0, writeEnable[4], 1'b0, writeEnable[3], 1'b0, writeEnable[2], 1'b0, writeEnable[1],
          1'b0, writeEnable[0]} << mux_address);
        new_data =  ( {1'b0, wordtemp[127], 1'b0, wordtemp[126], 1'b0, wordtemp[125],
          1'b0, wordtemp[124], 1'b0, wordtemp[123], 1'b0, wordtemp[122], 1'b0, wordtemp[121],
          1'b0, wordtemp[120], 1'b0, wordtemp[119], 1'b0, wordtemp[118], 1'b0, wordtemp[117],
          1'b0, wordtemp[116], 1'b0, wordtemp[115], 1'b0, wordtemp[114], 1'b0, wordtemp[113],
          1'b0, wordtemp[112], 1'b0, wordtemp[111], 1'b0, wordtemp[110], 1'b0, wordtemp[109],
          1'b0, wordtemp[108], 1'b0, wordtemp[107], 1'b0, wordtemp[106], 1'b0, wordtemp[105],
          1'b0, wordtemp[104], 1'b0, wordtemp[103], 1'b0, wordtemp[102], 1'b0, wordtemp[101],
          1'b0, wordtemp[100], 1'b0, wordtemp[99], 1'b0, wordtemp[98], 1'b0, wordtemp[97],
          1'b0, wordtemp[96], 1'b0, wordtemp[95], 1'b0, wordtemp[94], 1'b0, wordtemp[93],
          1'b0, wordtemp[92], 1'b0, wordtemp[91], 1'b0, wordtemp[90], 1'b0, wordtemp[89],
          1'b0, wordtemp[88], 1'b0, wordtemp[87], 1'b0, wordtemp[86], 1'b0, wordtemp[85],
          1'b0, wordtemp[84], 1'b0, wordtemp[83], 1'b0, wordtemp[82], 1'b0, wordtemp[81],
          1'b0, wordtemp[80], 1'b0, wordtemp[79], 1'b0, wordtemp[78], 1'b0, wordtemp[77],
          1'b0, wordtemp[76], 1'b0, wordtemp[75], 1'b0, wordtemp[74], 1'b0, wordtemp[73],
          1'b0, wordtemp[72], 1'b0, wordtemp[71], 1'b0, wordtemp[70], 1'b0, wordtemp[69],
          1'b0, wordtemp[68], 1'b0, wordtemp[67], 1'b0, wordtemp[66], 1'b0, wordtemp[65],
          1'b0, wordtemp[64], 1'b0, wordtemp[63], 1'b0, wordtemp[62], 1'b0, wordtemp[61],
          1'b0, wordtemp[60], 1'b0, wordtemp[59], 1'b0, wordtemp[58], 1'b0, wordtemp[57],
          1'b0, wordtemp[56], 1'b0, wordtemp[55], 1'b0, wordtemp[54], 1'b0, wordtemp[53],
          1'b0, wordtemp[52], 1'b0, wordtemp[51], 1'b0, wordtemp[50], 1'b0, wordtemp[49],
          1'b0, wordtemp[48], 1'b0, wordtemp[47], 1'b0, wordtemp[46], 1'b0, wordtemp[45],
          1'b0, wordtemp[44], 1'b0, wordtemp[43], 1'b0, wordtemp[42], 1'b0, wordtemp[41],
          1'b0, wordtemp[40], 1'b0, wordtemp[39], 1'b0, wordtemp[38], 1'b0, wordtemp[37],
          1'b0, wordtemp[36], 1'b0, wordtemp[35], 1'b0, wordtemp[34], 1'b0, wordtemp[33],
          1'b0, wordtemp[32], 1'b0, wordtemp[31], 1'b0, wordtemp[30], 1'b0, wordtemp[29],
          1'b0, wordtemp[28], 1'b0, wordtemp[27], 1'b0, wordtemp[26], 1'b0, wordtemp[25],
          1'b0, wordtemp[24], 1'b0, wordtemp[23], 1'b0, wordtemp[22], 1'b0, wordtemp[21],
          1'b0, wordtemp[20], 1'b0, wordtemp[19], 1'b0, wordtemp[18], 1'b0, wordtemp[17],
          1'b0, wordtemp[16], 1'b0, wordtemp[15], 1'b0, wordtemp[14], 1'b0, wordtemp[13],
          1'b0, wordtemp[12], 1'b0, wordtemp[11], 1'b0, wordtemp[10], 1'b0, wordtemp[9],
          1'b0, wordtemp[8], 1'b0, wordtemp[7], 1'b0, wordtemp[6], 1'b0, wordtemp[5],
          1'b0, wordtemp[4], 1'b0, wordtemp[3], 1'b0, wordtemp[2], 1'b0, wordtemp[1],
          1'b0, wordtemp[0]} << mux_address);
        row = (row & ~row_mask) | (row_mask & (~row_mask | new_data));
        mem[row_address] = row;
`ifdef ARM_BACKDOOR_NOCEN
`else
  	end
`endif
  	end
  end
  endtask

task dumpmem;
	input [1000*8-1:0] filename_dump;
	integer i, dump_file_desc;
	reg [BITS-1:0] wordtemp;
	reg [6:0] Atemp;
  begin
	dump_file_desc = $fopen(filename_dump);
`ifdef ARM_BACKDOOR_NOCEN
`else
	if (cen_ === 1'b1) begin
`endif
	  for (i=0;i<WORDS;i=i+1) begin
	  Atemp = i;
	  mux_address = (Atemp & 1'b1);
      row_address = (Atemp >> 1);
      row = mem[row_address];
        writeEnable = {128{1'b1}};
        data_out = (row >> (mux_address));
        readLatch0 = {data_out[254], data_out[252], data_out[250], data_out[248], data_out[246],
          data_out[244], data_out[242], data_out[240], data_out[238], data_out[236],
          data_out[234], data_out[232], data_out[230], data_out[228], data_out[226],
          data_out[224], data_out[222], data_out[220], data_out[218], data_out[216],
          data_out[214], data_out[212], data_out[210], data_out[208], data_out[206],
          data_out[204], data_out[202], data_out[200], data_out[198], data_out[196],
          data_out[194], data_out[192], data_out[190], data_out[188], data_out[186],
          data_out[184], data_out[182], data_out[180], data_out[178], data_out[176],
          data_out[174], data_out[172], data_out[170], data_out[168], data_out[166],
          data_out[164], data_out[162], data_out[160], data_out[158], data_out[156],
          data_out[154], data_out[152], data_out[150], data_out[148], data_out[146],
          data_out[144], data_out[142], data_out[140], data_out[138], data_out[136],
          data_out[134], data_out[132], data_out[130], data_out[128], data_out[126],
          data_out[124], data_out[122], data_out[120], data_out[118], data_out[116],
          data_out[114], data_out[112], data_out[110], data_out[108], data_out[106],
          data_out[104], data_out[102], data_out[100], data_out[98], data_out[96],
          data_out[94], data_out[92], data_out[90], data_out[88], data_out[86], data_out[84],
          data_out[82], data_out[80], data_out[78], data_out[76], data_out[74], data_out[72],
          data_out[70], data_out[68], data_out[66], data_out[64], data_out[62], data_out[60],
          data_out[58], data_out[56], data_out[54], data_out[52], data_out[50], data_out[48],
          data_out[46], data_out[44], data_out[42], data_out[40], data_out[38], data_out[36],
          data_out[34], data_out[32], data_out[30], data_out[28], data_out[26], data_out[24],
          data_out[22], data_out[20], data_out[18], data_out[16], data_out[14], data_out[12],
          data_out[10], data_out[8], data_out[6], data_out[4], data_out[2], data_out[0]};
        shifted_readLatch0 = readLatch0;
        q_int = {shifted_readLatch0[127], shifted_readLatch0[126], shifted_readLatch0[125],
          shifted_readLatch0[124], shifted_readLatch0[123], shifted_readLatch0[122],
          shifted_readLatch0[121], shifted_readLatch0[120], shifted_readLatch0[119],
          shifted_readLatch0[118], shifted_readLatch0[117], shifted_readLatch0[116],
          shifted_readLatch0[115], shifted_readLatch0[114], shifted_readLatch0[113],
          shifted_readLatch0[112], shifted_readLatch0[111], shifted_readLatch0[110],
          shifted_readLatch0[109], shifted_readLatch0[108], shifted_readLatch0[107],
          shifted_readLatch0[106], shifted_readLatch0[105], shifted_readLatch0[104],
          shifted_readLatch0[103], shifted_readLatch0[102], shifted_readLatch0[101],
          shifted_readLatch0[100], shifted_readLatch0[99], shifted_readLatch0[98],
          shifted_readLatch0[97], shifted_readLatch0[96], shifted_readLatch0[95], shifted_readLatch0[94],
          shifted_readLatch0[93], shifted_readLatch0[92], shifted_readLatch0[91], shifted_readLatch0[90],
          shifted_readLatch0[89], shifted_readLatch0[88], shifted_readLatch0[87], shifted_readLatch0[86],
          shifted_readLatch0[85], shifted_readLatch0[84], shifted_readLatch0[83], shifted_readLatch0[82],
          shifted_readLatch0[81], shifted_readLatch0[80], shifted_readLatch0[79], shifted_readLatch0[78],
          shifted_readLatch0[77], shifted_readLatch0[76], shifted_readLatch0[75], shifted_readLatch0[74],
          shifted_readLatch0[73], shifted_readLatch0[72], shifted_readLatch0[71], shifted_readLatch0[70],
          shifted_readLatch0[69], shifted_readLatch0[68], shifted_readLatch0[67], shifted_readLatch0[66],
          shifted_readLatch0[65], shifted_readLatch0[64], shifted_readLatch0[63], shifted_readLatch0[62],
          shifted_readLatch0[61], shifted_readLatch0[60], shifted_readLatch0[59], shifted_readLatch0[58],
          shifted_readLatch0[57], shifted_readLatch0[56], shifted_readLatch0[55], shifted_readLatch0[54],
          shifted_readLatch0[53], shifted_readLatch0[52], shifted_readLatch0[51], shifted_readLatch0[50],
          shifted_readLatch0[49], shifted_readLatch0[48], shifted_readLatch0[47], shifted_readLatch0[46],
          shifted_readLatch0[45], shifted_readLatch0[44], shifted_readLatch0[43], shifted_readLatch0[42],
          shifted_readLatch0[41], shifted_readLatch0[40], shifted_readLatch0[39], shifted_readLatch0[38],
          shifted_readLatch0[37], shifted_readLatch0[36], shifted_readLatch0[35], shifted_readLatch0[34],
          shifted_readLatch0[33], shifted_readLatch0[32], shifted_readLatch0[31], shifted_readLatch0[30],
          shifted_readLatch0[29], shifted_readLatch0[28], shifted_readLatch0[27], shifted_readLatch0[26],
          shifted_readLatch0[25], shifted_readLatch0[24], shifted_readLatch0[23], shifted_readLatch0[22],
          shifted_readLatch0[21], shifted_readLatch0[20], shifted_readLatch0[19], shifted_readLatch0[18],
          shifted_readLatch0[17], shifted_readLatch0[16], shifted_readLatch0[15], shifted_readLatch0[14],
          shifted_readLatch0[13], shifted_readLatch0[12], shifted_readLatch0[11], shifted_readLatch0[10],
          shifted_readLatch0[9], shifted_readLatch0[8], shifted_readLatch0[7], shifted_readLatch0[6],
          shifted_readLatch0[5], shifted_readLatch0[4], shifted_readLatch0[3], shifted_readLatch0[2],
          shifted_readLatch0[1], shifted_readLatch0[0]};
   	$fdisplay(dump_file_desc, "%b", q_int);
  end
`ifdef ARM_BACKDOOR_NOCEN
`else
  	end
`endif
    $fclose(dump_file_desc);
  end
  endtask

task loadaddr;
	input [6:0] load_addr;
	input [127:0] load_data;
	reg [BITS-1:0] wordtemp;
	reg [6:0] Atemp;
  begin
`ifdef ARM_BACKDOOR_NOCEN
`else
	if (cen_ === 1'b1) begin
`endif
	  wordtemp = load_data;
	  Atemp = load_addr;
	  mux_address = (Atemp & 1'b1);
      row_address = (Atemp >> 1);
      row = mem[row_address];
        writeEnable = {128{1'b1}};
        row_mask =  ( {1'b0, writeEnable[127], 1'b0, writeEnable[126], 1'b0, writeEnable[125],
          1'b0, writeEnable[124], 1'b0, writeEnable[123], 1'b0, writeEnable[122], 1'b0, writeEnable[121],
          1'b0, writeEnable[120], 1'b0, writeEnable[119], 1'b0, writeEnable[118], 1'b0, writeEnable[117],
          1'b0, writeEnable[116], 1'b0, writeEnable[115], 1'b0, writeEnable[114], 1'b0, writeEnable[113],
          1'b0, writeEnable[112], 1'b0, writeEnable[111], 1'b0, writeEnable[110], 1'b0, writeEnable[109],
          1'b0, writeEnable[108], 1'b0, writeEnable[107], 1'b0, writeEnable[106], 1'b0, writeEnable[105],
          1'b0, writeEnable[104], 1'b0, writeEnable[103], 1'b0, writeEnable[102], 1'b0, writeEnable[101],
          1'b0, writeEnable[100], 1'b0, writeEnable[99], 1'b0, writeEnable[98], 1'b0, writeEnable[97],
          1'b0, writeEnable[96], 1'b0, writeEnable[95], 1'b0, writeEnable[94], 1'b0, writeEnable[93],
          1'b0, writeEnable[92], 1'b0, writeEnable[91], 1'b0, writeEnable[90], 1'b0, writeEnable[89],
          1'b0, writeEnable[88], 1'b0, writeEnable[87], 1'b0, writeEnable[86], 1'b0, writeEnable[85],
          1'b0, writeEnable[84], 1'b0, writeEnable[83], 1'b0, writeEnable[82], 1'b0, writeEnable[81],
          1'b0, writeEnable[80], 1'b0, writeEnable[79], 1'b0, writeEnable[78], 1'b0, writeEnable[77],
          1'b0, writeEnable[76], 1'b0, writeEnable[75], 1'b0, writeEnable[74], 1'b0, writeEnable[73],
          1'b0, writeEnable[72], 1'b0, writeEnable[71], 1'b0, writeEnable[70], 1'b0, writeEnable[69],
          1'b0, writeEnable[68], 1'b0, writeEnable[67], 1'b0, writeEnable[66], 1'b0, writeEnable[65],
          1'b0, writeEnable[64], 1'b0, writeEnable[63], 1'b0, writeEnable[62], 1'b0, writeEnable[61],
          1'b0, writeEnable[60], 1'b0, writeEnable[59], 1'b0, writeEnable[58], 1'b0, writeEnable[57],
          1'b0, writeEnable[56], 1'b0, writeEnable[55], 1'b0, writeEnable[54], 1'b0, writeEnable[53],
          1'b0, writeEnable[52], 1'b0, writeEnable[51], 1'b0, writeEnable[50], 1'b0, writeEnable[49],
          1'b0, writeEnable[48], 1'b0, writeEnable[47], 1'b0, writeEnable[46], 1'b0, writeEnable[45],
          1'b0, writeEnable[44], 1'b0, writeEnable[43], 1'b0, writeEnable[42], 1'b0, writeEnable[41],
          1'b0, writeEnable[40], 1'b0, writeEnable[39], 1'b0, writeEnable[38], 1'b0, writeEnable[37],
          1'b0, writeEnable[36], 1'b0, writeEnable[35], 1'b0, writeEnable[34], 1'b0, writeEnable[33],
          1'b0, writeEnable[32], 1'b0, writeEnable[31], 1'b0, writeEnable[30], 1'b0, writeEnable[29],
          1'b0, writeEnable[28], 1'b0, writeEnable[27], 1'b0, writeEnable[26], 1'b0, writeEnable[25],
          1'b0, writeEnable[24], 1'b0, writeEnable[23], 1'b0, writeEnable[22], 1'b0, writeEnable[21],
          1'b0, writeEnable[20], 1'b0, writeEnable[19], 1'b0, writeEnable[18], 1'b0, writeEnable[17],
          1'b0, writeEnable[16], 1'b0, writeEnable[15], 1'b0, writeEnable[14], 1'b0, writeEnable[13],
          1'b0, writeEnable[12], 1'b0, writeEnable[11], 1'b0, writeEnable[10], 1'b0, writeEnable[9],
          1'b0, writeEnable[8], 1'b0, writeEnable[7], 1'b0, writeEnable[6], 1'b0, writeEnable[5],
          1'b0, writeEnable[4], 1'b0, writeEnable[3], 1'b0, writeEnable[2], 1'b0, writeEnable[1],
          1'b0, writeEnable[0]} << mux_address);
        new_data =  ( {1'b0, wordtemp[127], 1'b0, wordtemp[126], 1'b0, wordtemp[125],
          1'b0, wordtemp[124], 1'b0, wordtemp[123], 1'b0, wordtemp[122], 1'b0, wordtemp[121],
          1'b0, wordtemp[120], 1'b0, wordtemp[119], 1'b0, wordtemp[118], 1'b0, wordtemp[117],
          1'b0, wordtemp[116], 1'b0, wordtemp[115], 1'b0, wordtemp[114], 1'b0, wordtemp[113],
          1'b0, wordtemp[112], 1'b0, wordtemp[111], 1'b0, wordtemp[110], 1'b0, wordtemp[109],
          1'b0, wordtemp[108], 1'b0, wordtemp[107], 1'b0, wordtemp[106], 1'b0, wordtemp[105],
          1'b0, wordtemp[104], 1'b0, wordtemp[103], 1'b0, wordtemp[102], 1'b0, wordtemp[101],
          1'b0, wordtemp[100], 1'b0, wordtemp[99], 1'b0, wordtemp[98], 1'b0, wordtemp[97],
          1'b0, wordtemp[96], 1'b0, wordtemp[95], 1'b0, wordtemp[94], 1'b0, wordtemp[93],
          1'b0, wordtemp[92], 1'b0, wordtemp[91], 1'b0, wordtemp[90], 1'b0, wordtemp[89],
          1'b0, wordtemp[88], 1'b0, wordtemp[87], 1'b0, wordtemp[86], 1'b0, wordtemp[85],
          1'b0, wordtemp[84], 1'b0, wordtemp[83], 1'b0, wordtemp[82], 1'b0, wordtemp[81],
          1'b0, wordtemp[80], 1'b0, wordtemp[79], 1'b0, wordtemp[78], 1'b0, wordtemp[77],
          1'b0, wordtemp[76], 1'b0, wordtemp[75], 1'b0, wordtemp[74], 1'b0, wordtemp[73],
          1'b0, wordtemp[72], 1'b0, wordtemp[71], 1'b0, wordtemp[70], 1'b0, wordtemp[69],
          1'b0, wordtemp[68], 1'b0, wordtemp[67], 1'b0, wordtemp[66], 1'b0, wordtemp[65],
          1'b0, wordtemp[64], 1'b0, wordtemp[63], 1'b0, wordtemp[62], 1'b0, wordtemp[61],
          1'b0, wordtemp[60], 1'b0, wordtemp[59], 1'b0, wordtemp[58], 1'b0, wordtemp[57],
          1'b0, wordtemp[56], 1'b0, wordtemp[55], 1'b0, wordtemp[54], 1'b0, wordtemp[53],
          1'b0, wordtemp[52], 1'b0, wordtemp[51], 1'b0, wordtemp[50], 1'b0, wordtemp[49],
          1'b0, wordtemp[48], 1'b0, wordtemp[47], 1'b0, wordtemp[46], 1'b0, wordtemp[45],
          1'b0, wordtemp[44], 1'b0, wordtemp[43], 1'b0, wordtemp[42], 1'b0, wordtemp[41],
          1'b0, wordtemp[40], 1'b0, wordtemp[39], 1'b0, wordtemp[38], 1'b0, wordtemp[37],
          1'b0, wordtemp[36], 1'b0, wordtemp[35], 1'b0, wordtemp[34], 1'b0, wordtemp[33],
          1'b0, wordtemp[32], 1'b0, wordtemp[31], 1'b0, wordtemp[30], 1'b0, wordtemp[29],
          1'b0, wordtemp[28], 1'b0, wordtemp[27], 1'b0, wordtemp[26], 1'b0, wordtemp[25],
          1'b0, wordtemp[24], 1'b0, wordtemp[23], 1'b0, wordtemp[22], 1'b0, wordtemp[21],
          1'b0, wordtemp[20], 1'b0, wordtemp[19], 1'b0, wordtemp[18], 1'b0, wordtemp[17],
          1'b0, wordtemp[16], 1'b0, wordtemp[15], 1'b0, wordtemp[14], 1'b0, wordtemp[13],
          1'b0, wordtemp[12], 1'b0, wordtemp[11], 1'b0, wordtemp[10], 1'b0, wordtemp[9],
          1'b0, wordtemp[8], 1'b0, wordtemp[7], 1'b0, wordtemp[6], 1'b0, wordtemp[5],
          1'b0, wordtemp[4], 1'b0, wordtemp[3], 1'b0, wordtemp[2], 1'b0, wordtemp[1],
          1'b0, wordtemp[0]} << mux_address);
        row = (row & ~row_mask) | (row_mask & (~row_mask | new_data));
        mem[row_address] = row;
`ifdef ARM_BACKDOOR_NOCEN
`else
  	end
`endif
  	end
  endtask
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
